gilbertorconde/libre-oven/project/docs/meireles_mf_7606_x_info.md

# Meireles MF 7606 X Oven Information

## Overview

The Meireles MF 7606 X is a built-in electric multifunction oven designed for versatile cooking. It offers a range of features to enhance your culinary experience.

## Key Features

- **Oven Type:** Electric multifunction
- **Functions:** 6 cooking functions, including:
  - Grill
  - Grill with top element
  - Bottom element
  - Top and bottom element
  - Top and bottom element with fan
  - Grill with bottom element and ventilation
- **Cooling System:** Tangential cooling fan
- **Controls:** Cylindrical knobs
- **Timer:** Minute minder
- **Interior Features:**
  - Lateral grids with anti-tilt system
  - Easy-to-clean enamel
  - Double removable glass door
- **Energy Efficiency:** Class A

## Technical Specifications

- **Oven Capacity:** 55 liters
- **Energy Consumption:**
  - Conventional heating: 0.79 kWh
  - Forced air heating: 0.75 kWh
- **Power Ratings:**
  - **Grill:** 1500 W
  - **Top element:** 1100 W
  - **Bottom element:** 1500 W
  - **Maximum power:** 2654 W
- **Electrical Requirements:** 220-240V / 50-60 Hz
- **Dimensions (W x H x D):** 598 x 580 x 500 mm
- **Packaging dimensions:** 665 x 670 x 580 mm
- **Weight:**
  - Net: 29 kg
  - Gross: 32 kg

## Function Mapping

According to official specifications, the oven has 6 functions:

1. **Grill** - 1500 W grill element
2. **Grill with top element** - Grill + Top element (1100 W)
3. **Bottom element** - Bottom element only (1500 W)
4. **Top and bottom element** - Both elements together (1100 W + 1500 W = 2600 W)
5. **Top and bottom element with fan** - Both elements + fan (convection mode)
6. **Grill with bottom element and ventilation** - Grill + Bottom + Fan

## Notes on Wiring Analysis

**Important discrepancy:** The official specifications indicate this oven **does have a grill function** (1500 W), but the wiring analysis shows that pin p4 (which would control the grill) has no wire connected.

This suggests:
- The grill might be wired differently than expected
- The grill might share wiring with another element
- The specific unit might have a modification or wiring issue
- The grill control might be integrated differently in the camshaft switch

**Recommendation:** Physically verify the presence of a grill element inside the oven cavity and trace its wiring to confirm how it's actually connected.

## Additional Resources

- Official product page: [Meireles MF 7606 X](https://www.meireles.pt/en/produto/appliances/ovens/electric-ovens/mf-7606-x/)
- Product manual: [Meireles MF 7606 X Manual](https://www.manua.ls/meireles/mf-7606-x/specifications)
- Product datasheet: [MF 7606 X Product Sheet](https://www.meireles.pt/wp-content/uploads/2020/04/MF-7606-X-%E2%80%94-Fichas-de-produto.pdf)

---

*Information gathered from web search. Specifications and features are subject to change. For the most accurate and up-to-date information, consult the official Meireles website or the product manual.*
