gilbertorconde/libre-oven/project/cad/oven-rotery-holder.FCStd

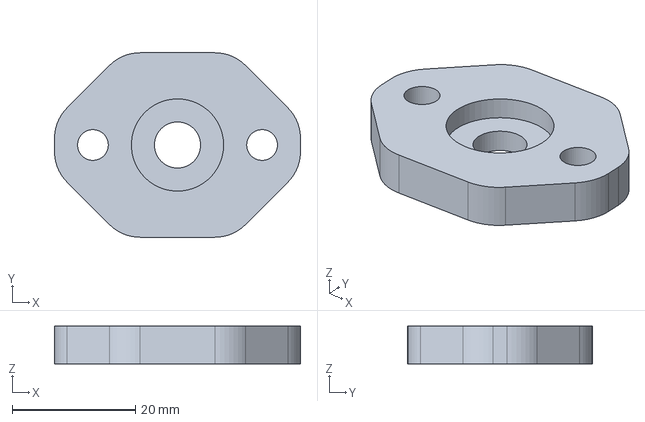
[picture p30: CAD file, 2026-03-03]
project/cad/oven-rotery-holder.FCStd
40.0 x 30.0 x 6.10 mm
