gilbertorconde/libre-oven/project/cad/lcd-box.FCStd

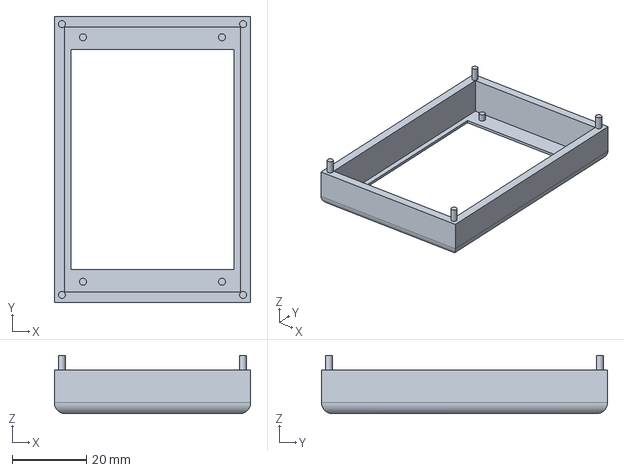
[picture p31: CAD file, 2026-03-03]
project/cad/lcd-box.FCStd
52.9 x 77.0 x 15.7 mm
