gilbertorconde/libre-oven/(list of files, cad)

Other CAD files:
project/cad/lcd-box-Body.stl
project/cad/oven-rotery-holder-Body.stl
