gilbertorconde/libre-oven/(list of files, drawings)

Other design files:
project/pcb/libre_oven_devkit.eprj
