gilbertorconde/libre-oven/project/esp32/libre_oven_s3.yaml

esphome:
  name: libre-oven
  friendly_name: Libre Oven
  comment: Libre Oven Controller Firmware
  on_boot:
    priority: -100
    then:
      - script.execute: wake_screen
      # Startup splash: sensor data needs ~10s to settle, so the UI and the
      # knobs stay disabled until then. A flag (not millis()) so the splash
      # doesn't come back when millis() wraps after ~49.7 days.
      - delay: 12s
      - globals.set:
          id: startup_done
          value: "true"

esp32:
  board: esp32-s3-devkitc-1
  variant: esp32s3
  framework:
    type: esp-idf
    sdkconfig_options:
      CONFIG_ESPTOOLPY_FLASHMODE_QIO: "y"

psram:
  mode: octal
  speed: 80MHz

# WiFi Configuration
wifi:
  ssid: !secret wifi_ssid
  password: !secret wifi_password

  # Enable fallback hotspot in case WiFi connection fails
  ap:
    ssid: "Libre-Oven-PT100 Fallback"
    password: !secret wifi_password

# Note: captive_portal is unsupported on ESP-IDF.
# improv_serial was tried but it blocks the main loop for 300-600ms,
# corrupting SPI reads from the MAX31865 RTD sensor.

# Logger - silenced except PID autotune output
logger:
  level: DEBUG
  deassert_rts_dtr: true
  logs:
    component: NONE
    sensor: ERROR
    sensor.filter: ERROR
    display: ERROR
    wifi: ERROR
    api: ERROR
    api.connection: ERROR
    ota: ERROR
    mdns: ERROR
    esp-idf: ERROR
    esp32.preferences: ERROR
    switch: ERROR
    number: ERROR
    text_sensor: ERROR
    binary_sensor: ERROR
    climate: ERROR
    pid: DEBUG
    pid.autotune: DEBUG
    pid.climate: DEBUG
    output: ERROR
    light: ERROR
    script: ERROR
    scheduler: ERROR
    max31865: NONE
    spi: ERROR
    app: ERROR

# Enable Home Assistant API
api:
  encryption:
    key: !secret api_encryption_key

# Enable Over-The-Air updates. `encryption:` with no key reuses the API
# encryption key above, so OTA images are encrypted, not just authenticated.
ota:
  - platform: esphome
    encryption:
  - platform: web_server

# Enable web server for local access
web_server:
  port: 80
  # Required: the web_server OTA above is otherwise an unauthenticated
  # firmware upload (the esphome OTA encryption doesn't cover it).
  auth:
    type: digest
    username: admin
    password: !secret ota_password

# Commit restored globals (program state, timers) to flash every 5s instead of
# the default 60s, so a power cut shortly after cancelling can't resume the
# cancelled program. NVS is wear-levelled; 5s is fine for this write volume.
preferences:
  flash_write_interval: 5s

# Status LED (onboard LED)
status_led:
  pin:
    number: GPIO48
    inverted: true

#####################################
# Display Configuration
#####################################
#
# ST7789V TFT Display - SPI (240x320 panel, landscape UI via rotation)
#   SCK:  GPIO14 (HSPI SCK)
#   MOSI: GPIO13 (HSPI MOSI)
#   CS:   GPIO15
#   DC:   GPIO12
#   BLK:  GPIO11 (Backlight PWM)
#   RST:  Not connected (using software reset)
#
#####################################

# SPI Bus for Display
spi:
  - id: spi_display
    clk_pin: GPIO14
    mosi_pin: GPIO13

  # SPI bus for MAX31865 PT100 RTD
  # Software SPI: more tolerant of long wires and noise.
  - id: spi_max31865
    clk_pin: GPIO18
    mosi_pin: GPIO16
    miso_pin: GPIO19
    # interface: software

# Display Backlight PWM
output:
  - platform: ledc
    id: backlight_pwm
    pin: GPIO11
    frequency: 1000Hz

  # Buzzer output (simple on/off beep)
  - platform: gpio
    id: buzzer_output
    pin: GPIO6

  # PID heat output: time-proportioning for SSR control.
  - platform: slow_pwm
    id: pid_heat_output
    period: 10s
    turn_on_action:
      - lambda: |-
          if (id(active_top_element)) id(top_element_relay).turn_on();
          if (id(active_bottom_element)) id(bottom_element_relay).turn_on();
          if (id(active_grill_element)) id(grill_element_relay).turn_on();
    turn_off_action:
      - lambda: |-
          id(top_element_relay).turn_off();
          id(bottom_element_relay).turn_off();
          id(grill_element_relay).turn_off();

# Backlight Control
light:
  - platform: monochromatic
    output: backlight_pwm
    name: "Display Backlight"
    id: display_backlight
    restore_mode: ALWAYS_ON
    default_transition_length: 0s

# PID Climate Controller
# Autotune results (PWM period: 2s, sensor rate: 500ms):
#   control_parameters:
#     kp: 0.06067
#     ki: 0.00026
#     kd: 3.59330
#
#   Alternative Rules:
#     Rule 'Ziegler-Nichols PI':
#       kp: 0.04550, ki: 0.00012, kd: 0.00000
#     Rule 'Pessen Integral PID':
#       kp: 0.07078, ki: 0.00037, kd: 5.03062
#     Rule 'Some Overshoot PID':
#       kp: 0.03367, ki: 0.00014, kd: 5.31808
#     Rule 'No Overshoot PID':
#       kp: 0.02022, ki: 0.00009, kd: 2.99441
#
# Previous autotune results (PWM period: 10s, sensor rate: 1s):
#   control_parameters:
#     kp: 0.06512
#     ki: 0.00032
#     kd: 3.36308
#
#   Alternative Rules:
#     Rule 'Ziegler-Nichols PI':
#       kp: 0.04884, ki: 0.00014, kd: 0.00000
#     Rule 'Pessen Integral PID':
#       kp: 0.07598, ki: 0.00046, kd: 4.70831
#     Rule 'Some Overshoot PID':
#       kp: 0.03614, ki: 0.00018, kd: 4.97736
#     Rule 'No Overshoot PID':
#       kp: 0.02171, ki: 0.00011, kd: 2.80257
climate:
  - platform: pid
    id: pid_climate
    name: "Oven PID"
    sensor: runtime_temperature
    default_target_temperature: 200°C
    heat_output: pid_heat_output
    control_parameters:
      kp: 0.06067
      ki: 0.00026
      kd: 5.59330
      min_integral: -0.3
      max_integral: 0.3
      output_averaging_samples: 10
      derivative_averaging_samples: 10
    deadband_parameters:
      threshold_high: 5.0°C
      threshold_low: -5.0°C
      kp_multiplier: 0.05
      ki_multiplier: 0.05
      deadband_output_averaging_samples: 15

# ST7789V TFT Display
color:
  - id: background_color
    hex: FFFFFF
  - id: text_color
    hex: 161616
  - id: off_element
    hex: e2e2e2
  - id: on_element
    hex: 00c0e5
  - id: hot_element
    hex: 001ee0
  - id: selected_element
    hex: 161616

display:
  # ST7789V via mipi_spi. Panel is 240x320 native; UI is 320x240 landscape.
  # rotation: 90 is upside-down on this mounting — use 270 instead.
  - platform: mipi_spi
    id: oven_display
    model: ST7789V
    spi_id: spi_display
    cs_pin: GPIO15
    dc_pin: GPIO12
    rotation: 270
    # Default is 10MHz: a full 320x240x16bit frame then takes ~123ms to send,
    # which nearly saturates the main loop at a 125ms update interval.
    # Drop to 20MHz if the panel shows artifacts.
    data_rate: 40MHz
    update_interval: 125ms
    auto_clear_enabled: true

    lambda: |-
      // Clear entire screen to black first (full physical frame, NOT offset, so
      // shifting the UI never leaves stale/garbage pixels at the edges).
      it.filled_rectangle(0, 0, it.get_width(), it.get_height(), id(background_color));

      // ── Global UI offset wrappers ─────────────────────────────────
      // Every draw call below goes through these so the whole UI can be
      // nudged by (ui_offset_x, ui_offset_y) to fine-tune centering / fix any
      // edge clipping. Tune via the HA "UI Offset X/Y" sliders, then bake the
      // values into the ui_offset_x/ui_offset_y globals.
      const int OX = id(ui_offset_x);
      const int OY = id(ui_offset_y);
      auto P  = [&](int x, int y, auto&&... a) { it.print(x + OX, y + OY, a...); };
      auto PF = [&](int x, int y, auto&&... a) { it.printf(x + OX, y + OY, a...); };
      auto LN = [&](int x1, int y1, int x2, int y2, auto&&... a) { it.line(x1 + OX, y1 + OY, x2 + OX, y2 + OY, a...); };
      auto FR = [&](int x, int y, int w, int h, auto&&... a) { it.filled_rectangle(x + OX, y + OY, w, h, a...); };
      auto RC = [&](int x, int y, int w, int h, auto&&... a) { it.rectangle(x + OX, y + OY, w, h, a...); };
      auto FC = [&](int x, int y, auto&&... a) { it.filled_circle(x + OX, y + OY, a...); };
      auto PX = [&](int x, int y, auto&&... a) { it.draw_pixel_at(x + OX, y + OY, a...); };

      // When sleeping, keep a blank frame and skip all heavy drawing.
      // This keeps runtime logic independent and avoids UI burn patterns.
      if (id(screen_sleeping)) {
        return;
      }

      // ── Startup splash (first 12 seconds) ──────────────────────
      // Sensor data is ignored for 10s; display stays 2s longer so
      // the first real median is ready before the UI appears.
      if (!id(startup_done)) {
        int cx = it.get_width() / 2;
        int cy = it.get_height() / 2;
        P(cx, cy - 20, id(font_normal), id(text_color),
                 TextAlign::CENTER, "Starting up...");

        // Animated dots: cycle 1-3 dots every ~500ms
        int dots = ((millis() / 500) % 3) + 1;
        const char *dot_str = dots == 1 ? "." : (dots == 2 ? ".." : "...");
        P(cx, cy + 15, id(font_normal), id(off_element),
                 TextAlign::CENTER, dot_str);
        return;
      }

      // ── Temperature fault: overrides every page until cleared ──────
      if (id(sensor_fault)) {
        int cx = it.get_width() / 2;
        int cy = it.get_height() / 2;
        P(cx, cy - 45, id(font_large), id(hot_element), TextAlign::CENTER,
                 id(fault_reason) == 2 ? "OVER TEMP" : "SENSOR FAULT");
        P(cx, cy - 5, id(font_normal), id(text_color), TextAlign::CENTER, "Heating disabled");
        if (std::isnan(id(current_oven_temp))) {
          P(cx, cy + 25, id(font_normal), id(text_color), TextAlign::CENTER, "Oven: --");
        } else {
          PF(cx, cy + 25, id(font_normal), id(text_color), TextAlign::CENTER,
                    "Oven: %.0f°C", id(current_oven_temp));
        }
        P(cx, it.get_height() - 8, id(font_small), id(off_element), TextAlign::BOTTOM_CENTER,
                 "Press any knob to retry");
        return;
      }

      // Get current page
      int page = id(current_page);

      // ═══════════════════════════════════════════════════════════
      // PAGE 0: MAIN SCREEN
      // ═══════════════════════════════════════════════════════════
      if (page == 0) {
        // ═══════════════════════════════════════════════════════════
        // STATE VARIABLES for 4-state / 3-state display coloring
        // ═══════════════════════════════════════════════════════════
        // SSR actual state (is it on right now?)
        bool top_ssr = id(top_element_relay).state;
        bool bottom_ssr = id(bottom_element_relay).state;
        bool grill_ssr = id(grill_element_relay).state;
        bool fan_ssr = id(fan_relay).state;
        bool light_ssr = id(light_relay).state || top_ssr || bottom_ssr || grill_ssr || fan_ssr;

        // Draft selection (user chose on mode screen)
        bool top_draft = id(desired_top_element);
        bool bottom_draft = id(desired_bottom_element);
        bool grill_draft = id(desired_grill_element);
        bool fan_draft = id(desired_fan_element);
        bool any_draft = top_draft || bottom_draft || grill_draft || fan_draft;

        // Active selection (applied to running program)
        bool top_active = id(active_top_element);
        bool bottom_active = id(active_bottom_element);
        bool grill_active = id(active_grill_element);
        bool fan_active = id(active_fan_element);
        bool any_active = top_active || bottom_active || grill_active || fan_active;

        float current_temp = id(current_oven_temp);
        float target = id(active_temperature);

        bool any_heating_active = top_active || bottom_active || grill_active;
        bool allow_heat =
          (target > 0.0f && any_heating_active) &&
          (id(timer_state) == 2 || id(timer_state) == 3 || id(timer_state) == 4);

        // ═══════════════════════════════════════════════════════════
        // 4-STATE COLOR LOGIC for heating elements (top, bottom, grill):
        //   Gray  = not selected, no program
        //   White = selected in draft, program not applied
        //   Yellow = program applied/armed, SSR off (temp cycling)
        //   Red   = SSR actually on (heating)
        // 3-STATE for non-cycling (fan, light/frame):
        //   Gray  = off
        //   White = draft selected, not active
        //   Yellow = SSR on (active)
        // ═══════════════════════════════════════════════════════════
        auto heating_color = [&](bool ssr, bool active, bool draft) -> Color {
          if (ssr)                     return id(on_element);       // red: SSR on
          if (allow_heat && active)    return id(hot_element);      // yellow: armed
          if (draft || active)         return id(selected_element); // white: draft/selected
          return id(off_element);                                   // gray: off
        };
        auto aux_color = [&](bool ssr, bool active, bool draft) -> Color {
          if (ssr)                     return id(hot_element);      // yellow: SSR on
          if (draft || active)         return id(selected_element); // white: draft/selected
          return id(off_element);                                   // gray: off
        };

        Color top_color = heating_color(top_ssr, top_active, top_draft);
        Color bottom_color = heating_color(bottom_ssr, bottom_active, bottom_draft);
        Color grill_color = heating_color(grill_ssr, grill_active, grill_draft);
        Color fan_color = aux_color(fan_ssr, fan_active, fan_draft);

      // Determine which timer to display on main screen
      int shown_sec = 0;
      Color timer_color = id(off_element);
      int state = id(timer_state);

      if (state == 1 || state == 2) {
        // Delay / preheating phase → yellow
        shown_sec = id(timer_delay_remaining);
        timer_color = id(hot_element);  // yellow-ish
      } else if (state == 3) {
        // Ready phase → green (holding at temperature)
        shown_sec = id(timer_cook_remaining);
        timer_color = id(on_element);
      } else if (state == 4) {
        // Cooking phase → green
        shown_sec = id(timer_cook_remaining);
        timer_color = id(on_element);
      } else {
        shown_sec = 0;
        timer_color = id(off_element);
      }

      // Is any program actively running?
      bool program_active = (state != 0);

      // ═══════════════════════════════════════════════════════════
      // SVG GROUP TRANSFORM: translate(54, 28.30137)
      // All oven elements offset by this amount
      // ═══════════════════════════════════════════════════════════
      const int tx = 54;
      const int ty = 28;

      // Offsets to fine-tune oven position
      const int oven_x_offset = 10;  // Horizontal offset (move right)
      const int oven_y_offset = -15; // Vertical offset (move up to center)

      // ═══════════════════════════════════════════════════════════
      // OVEN RECTANGLE (with rounded corners)
      // SVG: x=74.95, y=42.93, w=170.09, h=154.13, rx/ry=30.82
      // ═══════════════════════════════════════════════════════════
        Color oven_color = aux_color(light_ssr, any_active, any_draft);
      int oven_x = 75 + tx + oven_x_offset;     // 129 + offset
      int oven_y = 43 + ty + oven_y_offset;     // 71 + offset
      int oven_w = 170;
      int oven_h = 154;
      int corner_r = 31;

      // Draw oven_color rounded rectangle (4px stroke)
      // Straight edges
      LN(oven_x + corner_r, oven_y, oven_x + oven_w - corner_r, oven_y, oven_color);
      LN(oven_x + corner_r, oven_y + 1, oven_x + oven_w - corner_r, oven_y + 1, oven_color);
      LN(oven_x + corner_r, oven_y + 2, oven_x + oven_w - corner_r, oven_y + 2, oven_color);

      LN(oven_x + corner_r, oven_y + oven_h, oven_x + oven_w - corner_r, oven_y + oven_h, oven_color);
      LN(oven_x + corner_r, oven_y + oven_h - 1, oven_x + oven_w - corner_r, oven_y + oven_h - 1, oven_color);
      LN(oven_x + corner_r, oven_y + oven_h - 2, oven_x + oven_w - corner_r, oven_y + oven_h - 2, oven_color);

      LN(oven_x, oven_y + corner_r, oven_x, oven_y + oven_h - corner_r, oven_color);
      LN(oven_x + 1, oven_y + corner_r, oven_x + 1, oven_y + oven_h - corner_r, oven_color);
      LN(oven_x + 2, oven_y + corner_r, oven_x + 2, oven_y + oven_h - corner_r, oven_color);

      LN(oven_x + oven_w, oven_y + corner_r, oven_x + oven_w, oven_y + oven_h - corner_r, oven_color);
      LN(oven_x + oven_w - 1, oven_y + corner_r, oven_x + oven_w - 1, oven_y + oven_h - corner_r, oven_color);
      LN(oven_x + oven_w - 2, oven_y + corner_r, oven_x + oven_w - 2, oven_y + oven_h - corner_r, oven_color);

      // Rounded corners - draw only the arc quadrants using angles
      for (int r = corner_r - 2; r <= corner_r; r++) {
        // Top-left corner: 180° to 270°
        for (int angle = 180; angle <= 270; angle += 2) {
          int x = oven_x + corner_r + (int)(r * cos(angle * 3.14159 / 180));
          int y = oven_y + corner_r + (int)(r * sin(angle * 3.14159 / 180));
          PX(x, y, oven_color);
        }
        // Top-right corner: 270° to 360°
        for (int angle = 270; angle <= 360; angle += 2) {
          int x = oven_x + oven_w - corner_r + (int)(r * cos(angle * 3.14159 / 180));
          int y = oven_y + corner_r + (int)(r * sin(angle * 3.14159 / 180));
          PX(x, y, oven_color);
        }
        // Bottom-left corner: 90° to 180°
        for (int angle = 90; angle <= 180; angle += 2) {
          int x = oven_x + corner_r + (int)(r * cos(angle * 3.14159 / 180));
          int y = oven_y + oven_h - corner_r + (int)(r * sin(angle * 3.14159 / 180));
          PX(x, y, oven_color);
        }
        // Bottom-right corner: 0° to 90°
        for (int angle = 0; angle <= 90; angle += 2) {
          int x = oven_x + oven_w - corner_r + (int)(r * cos(angle * 3.14159 / 180));
          int y = oven_y + oven_h - corner_r + (int)(r * sin(angle * 3.14159 / 180));
          PX(x, y, oven_color);
        }
      }

      // ═══════════════════════════════════════════════════════════
      // TOP HEATING ELEMENT (6px thick with rounded caps)
      // Color: yellow when ON, red when heating, gray when OFF
      // ═══════════════════════════════════════════════════════════
      for (int i = 0; i < 5; i++) {
        LN(151 + oven_x_offset, 86 + i + oven_y_offset, 277 + oven_x_offset, 86 + i + oven_y_offset, top_color);
      }
      // Rounded caps at both ends
      FC(151 + oven_x_offset, 88 + oven_y_offset, 2, top_color);  // Left cap
      FC(277 + oven_x_offset, 88 + oven_y_offset, 2, top_color);  // Right cap

      // ═══════════════════════════════════════════════════════════
      // GRILL ZIGZAG PATTERN (gray, 6px stroke)
      // SVG: 8 zigzag paths starting at y=68.76+28.3=97
      // ═══════════════════════════════════════════════════════════
      int zigzag_y = 97 + oven_y_offset;
      int zigzag_start_x = 150 + oven_x_offset;

      for (int i = 0; i < 8; i++) {
        int x_base = zigzag_start_x + (i * 16);
        // Each zigzag: up 8px right, down 14px, down 8px right
        for (int t = 0; t < 3; t++) {  // 3px thick lines
          LN(x_base + t, zigzag_y, x_base + 8 + t, zigzag_y + 14, grill_color);
          LN(x_base + 8 + t, zigzag_y + 14, x_base + 16 + t, zigzag_y, grill_color);
        }
      }

      // ═══════════════════════════════════════════════════════════
      // FAN - filled gray circle with black blades and center
      // Centered horizontally in oven, below grill
      // ═══════════════════════════════════════════════════════════
      int fan_x = oven_x + oven_w / 2;      // 214 (centered)
      int fan_y = 155 + oven_y_offset;  // Centered vertically in oven

      // Fill fan circle with appropriate color (yellow when ON, gray when OFF)
      FC(fan_x, fan_y, 37, fan_color);

      // Animate fan blades only when fan SSR is ON
      static int fan_angle = 0;
      if (fan_ssr) {
        fan_angle = (fan_angle + 8) % 360;  // Rotate 8 degrees per frame
      }


      // Calculate rotated blade endpoints
      float angle_rad = fan_angle * 3.14159 / 180.0;
      float cos_a = cos(angle_rad);
      float sin_a = sin(angle_rad);

      // Original blade 1 endpoints: (-34, -20) to (34, 20)
      int x1_start = fan_x + (int)(-34 * cos_a - (-20) * sin_a);
      int y1_start = fan_y + (int)(-34 * sin_a + (-20) * cos_a);
      int x1_end = fan_x + (int)(34 * cos_a - 20 * sin_a);
      int y1_end = fan_y + (int)(34 * sin_a + 20 * cos_a);

      // Original blade 2 endpoints: (-20, 34) to (20, -34) (perpendicular)
      int x2_start = fan_x + (int)(-20 * cos_a - 34 * sin_a);
      int y2_start = fan_y + (int)(-20 * sin_a + 34 * cos_a);
      int x2_end = fan_x + (int)(20 * cos_a - (-34) * sin_a);
      int y2_end = fan_y + (int)(20 * sin_a + (-34) * cos_a);

      // Draw background-colored X-pattern blades with consistent 8px thickness
      // Use circles along the line to create consistent thick lines

      // Blade 1: draw circles along the line from start to end
      for (float t = 0; t <= 1.0; t += 0.05) {
        int x = x1_start + (int)((x1_end - x1_start) * t);
        int y = y1_start + (int)((y1_end - y1_start) * t);
        FC(x, y, 4, id(background_color));  // radius 4 = 8px diameter
      }

      // Blade 2: draw circles along the line from start to end
      for (float t = 0; t <= 1.0; t += 0.05) {
        int x = x2_start + (int)((x2_end - x2_start) * t);
        int y = y2_start + (int)((y2_end - y2_start) * t);
        FC(x, y, 4, id(background_color));  // radius 4 = 8px diameter
      }

      // Background-colored center circle (motor hub)
      FC(fan_x, fan_y, 14, id(background_color));
      FC(fan_x, fan_y, 8, fan_color);

      // ═══════════════════════════════════════════════════════════
      // BOTTOM HEATING ELEMENT (6px thick with rounded caps)
      // Color: yellow when ON, red when heating, gray when OFF
      // ═══════════════════════════════════════════════════════════
      for (int i = 0; i < 5; i++) {
        LN(151 + oven_x_offset, 204 + i + oven_y_offset, 277 + oven_x_offset, 204 + i + oven_y_offset, bottom_color);
      }
      // Rounded caps at both ends
      FC(151 + oven_x_offset, 206 + oven_y_offset, 2, bottom_color);  // Left cap
      FC(277 + oven_x_offset, 206 + oven_y_offset, 2, bottom_color);  // Right cap

      // ═══════════════════════════════════════════════════════════
      // TEXT ELEMENTS (exact SVG coordinates)
      // ═══════════════════════════════════════════════════════════

      // Timer countdown and total - centered vertically
      // Font sizes: large=27px, small=15px, spacing between=7px
      // Total height: 27 + 7 + 15 = 49px
      int time_y_offset = 45;  // Adjust this to fine-tune vertical position
      int timer_countdown_height = 27;
      int timer_spacing = 7;
      int timer_total_height = 15;
      int timer_block_height = timer_countdown_height + timer_spacing + timer_total_height;
      int timer_start_y = (it.get_height() - timer_block_height) / 2 + time_y_offset;

      // ═══════════════════════════════════════════════════════════
      // Light Bulb Icon - top right, left of WiFi
      // ═══════════════════════════════════════════════════════════
      int bulb_x = it.get_width() - 60;  // Left of WiFi symbol
      int bulb_y = 15;                   // Aligned with WiFi
      Color bulb_color = aux_color(light_ssr, any_active, any_draft);

      // Bulb glass (circle)
      for (int r = 6; r <= 8; r++) {
        FC(bulb_x, bulb_y, r, bulb_color);
      }

      // Bulb base/socket (small rectangle)
      for (int i = 0; i < 3; i++) {
        LN(bulb_x - 3, bulb_y + 9 + i, bulb_x + 3, bulb_y + 9 + i, bulb_color);
      }

      // Bulb contact point (bottom line)
      LN(bulb_x - 2, bulb_y + 13, bulb_x + 2, bulb_y + 13, bulb_color);

      // ═══════════════════════════════════════════════════════════
      // Play/Pause Status Icon - left of light bulb
      // Pause (two bars) = idle, Play (triangle) = running
      // ═══════════════════════════════════════════════════════════
      int icon_x = bulb_x - 35;
      int icon_y = bulb_y + 2;  // Shift down to center with bulb's full extent
      Color icon_color = program_active ? id(hot_element) : id(selected_element);

      if (program_active) {
        // Play triangle (pointing right, ~18x22px to match bulb height)
        for (int dx = 0; dx <= 18; dx++) {
          int half_h = 11 - (11 * dx / 18);
          LN(icon_x + dx, icon_y - half_h, icon_x + dx, icon_y + half_h, icon_color);
        }
      } else {
        // Pause icon (two vertical bars, 5px wide each, 22px tall)
        FR(icon_x, icon_y - 11, 5, 22, icon_color);
        FR(icon_x + 9, icon_y - 11, 5, 22, icon_color);
      }

      // ═══════════════════════════════════════════════════════════
      // WiFi Status Indicator - top right corner
      // ═══════════════════════════════════════════════════════════
      int wifi_x = it.get_width() - 25;  // Right side, 25px from edge
      int wifi_y = 8;                    // Top corner

      if (wifi::global_wifi_component->is_connected()) {
        // Connected - Traditional WiFi symbol (curved arcs + dot pointing up)
        int wifi_center_y = wifi_y + 18;  // Bottom center point
        
        // Draw dot at bottom center
        FC(wifi_x, wifi_center_y, 2, id(text_color));
        
        // Draw 3 concentric arcs using angle-based drawing (pointing upward)
        // Small arc (innermost)
        for (int angle = 45; angle <= 135; angle += 3) {
          float rad = angle * 3.14159 / 180.0;
          for (int r = 6; r <= 8; r++) {
            int x = wifi_x + (int)(r * cos(rad));
            int y = wifi_center_y - (int)(r * sin(rad));
            PX(x, y, id(text_color));
          }
        }
        
        // Medium arc
        for (int angle = 45; angle <= 135; angle += 3) {
          float rad = angle * 3.14159 / 180.0;
          for (int r = 11; r <= 13; r++) {
            int x = wifi_x + (int)(r * cos(rad));
            int y = wifi_center_y - (int)(r * sin(rad));
            PX(x, y, id(text_color));
          }
        }
        
        // Large arc (outermost)
        for (int angle = 45; angle <= 135; angle += 3) {
          float rad = angle * 3.14159 / 180.0;
          for (int r = 16; r <= 18; r++) {
            int x = wifi_x + (int)(r * cos(rad));
            int y = wifi_center_y - (int)(r * sin(rad));
            PX(x, y, id(text_color));
          }
        }
      } else if (wifi::global_wifi_component->has_ap()) {
        // AP Mode - Circle with 4 radiating dots (broadcasting)
        FC(wifi_x, wifi_y + 8, 5, id(on_element));              // Center circle
        FC(wifi_x - 12, wifi_y + 8, 2, id(on_element));         // Left dot
        FC(wifi_x + 12, wifi_y + 8, 2, id(on_element));         // Right dot
        FC(wifi_x, wifi_y - 4, 2, id(on_element));              // Top dot
        FC(wifi_x, wifi_y + 20, 2, id(on_element));             // Bottom dot
      } else {
        // Disconnected - X symbol
        // Draw thick X with multiple lines
        for (int i = 0; i < 3; i++) {
          LN(wifi_x - 10, wifi_y + i, wifi_x + 10, wifi_y + 16 + i, id(hot_element));      // Top-left to bottom-right
          LN(wifi_x - 10, wifi_y + 16 + i, wifi_x + 10, wifi_y + i, id(hot_element));      // Bottom-left to top-right
        }
      }

      if (program_active) {
        // ═══ RUNNING: show active countdown ═══
        if (id(timer_state) == 2) {
          P(62, timer_start_y, id(font_normal), timer_color,
                   TextAlign::TOP_CENTER, "PREHEATING");
        } else if (id(timer_state) == 3) {
          P(62, timer_start_y, id(font_normal), id(on_element),
                   TextAlign::TOP_CENTER, "OVEN READY");
          P(62, timer_start_y + timer_countdown_height + timer_spacing,
                   id(font_small), id(text_color), TextAlign::TOP_CENTER,
                   "Press to start");
        } else if (id(timer_state) == 4 && id(cook_mode) == 1 && std::isnan(id(current_food_temp))) {
          // Probe mode cooking but the probe stopped reading (unplugged, or
          // below ~15°C where the 10K divider can't tell it from unplugged)
          P(62, timer_start_y, id(font_large), id(hot_element),
                   TextAlign::TOP_CENTER, "NO PROBE");
          P(62, timer_start_y + timer_countdown_height + timer_spacing,
                   id(font_small), id(text_color), TextAlign::TOP_CENTER,
                   "Check probe");
        } else if (id(timer_state) == 4 && id(cook_mode) == 1) {
          // Probe mode cooking: show food temp → target
          float ft = id(current_food_temp);
          float ft_target = id(food_target_temperature);
          PF(62, timer_start_y, id(font_large), id(on_element),
                    TextAlign::TOP_CENTER, "%.0f°C", ft);
          if (ft_target > 0.0f) {
            PF(62, timer_start_y + timer_countdown_height + timer_spacing,
                      id(font_small), id(text_color), TextAlign::TOP_CENTER,
                      "Target: %.0f°C", ft_target);
          } else {
            P(62, timer_start_y + timer_countdown_height + timer_spacing,
                     id(font_small), id(text_color), TextAlign::TOP_CENTER,
                     "PROBE MODE");
          }
        } else {
          int hours = shown_sec / 3600;
          int rem_sec = shown_sec % 3600;
          int mins = rem_sec / 60;
          int secs = rem_sec % 60;
          PF(62, timer_start_y, id(font_large), timer_color,
                    TextAlign::TOP_CENTER, "%02d:%02d:%02d", hours, mins, secs);
        }
        // Total programmed cook time (skip in ready state and probe-mode cooking)
        if (id(timer_state) == 3) {
          // Already displayed "Press to start" above
        } else if (id(timer_state) == 4 && id(cook_mode) == 1) {
          // Probe mode: sub-message already shown above
        } else if (id(cook_total_seconds) <= 0) {
          P(62, timer_start_y + timer_countdown_height + timer_spacing,
                   id(font_small), id(text_color), TextAlign::TOP_CENTER,
                   "NO TIMER");
        } else {
          int total_sec = id(cook_total_seconds);
          if (total_sec < 0) total_sec = 0;
          int t_hours = total_sec / 3600;
          int t_rem = total_sec % 3600;
          int t_mins = t_rem / 60;
          int t_secs = t_rem % 60;
          PF(62, timer_start_y + timer_countdown_height + timer_spacing,
                    id(font_small), id(text_color), TextAlign::TOP_CENTER,
                    "%02d:%02d:%02d", t_hours, t_mins, t_secs);
        }
        // Draft change indicator (when draft differs from active)
        bool temp_diff = ((int)id(working_temperature) != (int)target);
        bool time_diff = ((int)(id(working_timer) * 60.0f) != id(cook_total_seconds));
        if (temp_diff || time_diff) {
          int draft_y = timer_start_y + timer_countdown_height + timer_spacing + timer_total_height + 6;
          PF(62, draft_y, id(font_small), id(selected_element),
                    TextAlign::TOP_CENTER, "Draft: %.0f°C", id(working_temperature));
        }
      } else {
        // ═══ IDLE: show draft values in white ═══
        float draft_dur = id(working_timer);
        if (draft_dur > 0) {
          int d_total = (int)(draft_dur * 60.0f);
          int dh = d_total / 3600;
          int dr = d_total % 3600;
          int dm = dr / 60;
          int ds = dr % 60;
          PF(62, timer_start_y, id(font_large), id(selected_element),
                    TextAlign::TOP_CENTER, "%02d:%02d:%02d", dh, dm, ds);
        } else {
          P(62, timer_start_y, id(font_normal), id(selected_element),
                   TextAlign::TOP_CENTER, "NO TIMER");
        }
        // Show draft delay
        float draft_del = id(working_start_delay);
        if (draft_del > 0) {
          int del_h = (int)draft_del / 60;
          int del_m = (int)draft_del % 60;
          PF(62, timer_start_y + timer_countdown_height + timer_spacing,
                    id(font_small), id(selected_element), TextAlign::TOP_CENTER,
                    "Delay: %02d:%02d", del_h, del_m);
        } else {
          P(62, timer_start_y + timer_countdown_height + timer_spacing,
                   id(font_small), id(selected_element), TextAlign::TOP_CENTER,
                   "Start: Now");
        }
      }

      // Knob role labels at the very bottom
      int bottom_y = it.get_height() - 4;
      P(10, bottom_y, id(font_small), id(text_color),
               TextAlign::BOTTOM_LEFT, "TIME");
      P(it.get_width() / 2, bottom_y, id(font_small), id(text_color),
               TextAlign::BOTTOM_CENTER, "MODE");
      P(it.get_width() - 10, bottom_y, id(font_small), id(text_color),
               TextAlign::BOTTOM_RIGHT, "TEMP");

      // ═══════════════════════════════════════════════════════════
      // Temperature display - above timer
      // ═══════════════════════════════════════════════════════════
      int temp_spacing = 35;
      int current_temp_y = timer_start_y - temp_spacing;
      int target_temp_y = current_temp_y - 7 - 41;

        // Main temp: active when running, draft when idle
        float main_temp = program_active ? target : id(working_temperature);
        Color main_temp_color = program_active ? id(text_color) : id(selected_element);
        PF(62, target_temp_y, id(font_xlarge), main_temp_color, TextAlign::TOP_CENTER, "%.0f°C", main_temp);

        // Current real temp (small, yellow) - below main temp
        if (std::isnan(current_temp)) {
          P(62, current_temp_y, id(font_small), id(hot_element), TextAlign::TOP_CENTER, "--°C");
        } else {
          PF(62, current_temp_y, id(font_small), id(hot_element), TextAlign::TOP_CENTER, "%.0f°C", current_temp);
        }

        // Food probe temperature (only if probe is connected)
        if (!std::isnan(id(current_food_temp))) {
          PF(62, current_temp_y + 18, id(font_small), id(on_element), TextAlign::TOP_CENTER,
                    "Food: %.0f°C", id(current_food_temp));
        }
      }

      // ═══════════════════════════════════════════════════════════
      // PAGE 1: TIMER SCREEN
      // - First step: set duration (\"No timer\" → HH:MM)
      // - Second step: set start delay (\"Now\" → HH:MM)
      //   timer_edit_phase: 0 = editing duration, 1 = editing start delay
      // ═══════════════════════════════════════════════════════════
      else if (page == 1) {
        float duration_min = id(working_timer);
        float delay_min = id(working_start_delay);
        bool editing_duration = (id(timer_edit_phase) == 0);
        bool program_running = id(timer_state) >= 1;
        // Probe connected -> this page sets the food target instead of duration.
        bool probe_mode = (id(cook_mode) == 1);

        int cx = it.get_width() / 2;

        // Title
        P(cx, 8, id(font_normal), id(text_color), TextAlign::TOP_CENTER,
                 program_running ? (probe_mode ? "EDIT PROBE" : "EDIT TIMER")
                                 : (probe_mode ? "SET PROBE" : "SET TIMER"));

        // Helper lambda to print minutes as HH:MM
        auto print_time = [&](int x, int y, float minutes, bool active) {
          if (minutes <= 0.0f) return;
          int total = (int) minutes;
          if (total < 0) total = 0;
          if (total > 23 * 60 + 59) total = 23 * 60 + 59;
          int hours = total / 60;
          int mins = total % 60;
          Color col = active ? id(on_element) : id(text_color);
          PF(x, y, id(font_large), col, TextAlign::TOP_CENTER, "%02d:%02d", hours, mins);
        };

        // Primary block: food target (probe mode) or cook duration (timer mode)
        {
          Color label_color = editing_duration ? id(on_element) : id(text_color);
          if (probe_mode) {
            P(cx, 40, id(font_small), label_color,
                     TextAlign::TOP_CENTER, "FOOD TARGET");
            float ft = id(food_target_temperature);
            if (ft <= 0.0f) {
              Color col = editing_duration ? id(on_element) : id(off_element);
              P(cx, 68, id(font_large), col,
                       TextAlign::TOP_CENTER, "NOT SET");
            } else {
              Color col = editing_duration ? id(on_element) : id(text_color);
              PF(cx, 68, id(font_large), col,
                        TextAlign::TOP_CENTER, "%.0f°C", ft);
            }
          } else {
            P(cx, 40, id(font_small), label_color,
                     TextAlign::TOP_CENTER, "DURATION");
            if (duration_min <= 0.0f) {
              Color col = editing_duration ? id(on_element) : id(off_element);
              P(cx, 68, id(font_large), col,
                       TextAlign::TOP_CENTER, "NO TIMER");
            } else {
              print_time(cx, 68, duration_min, editing_duration);
            }
          }
        }

        // Start time block (delay) - LOCKED when program is running
        {
          bool delay_locked = program_running;
          bool editing_start = !editing_duration && !delay_locked;
          Color label_color = delay_locked ? id(off_element) : (editing_start ? id(on_element) : id(text_color));
          P(cx, 120, id(font_small), label_color,
                   TextAlign::TOP_CENTER, delay_locked ? "DELAY (LOCKED)" : "WHEN TO START");

          if (delay_min <= 0.0f) {
            Color col = editing_start ? id(on_element) : id(off_element);
            P(cx, 148, id(font_large), col,
                     TextAlign::TOP_CENTER, "NOW");
          } else {
            Color col = delay_locked ? id(off_element) : (editing_start ? id(on_element) : id(text_color));
            int total = (int) delay_min;
            if (total < 0) total = 0;
            int hours = total / 60;
            int mins = total % 60;
            PF(cx, 148, id(font_large), col, TextAlign::TOP_CENTER, "%02d:%02d", hours, mins);
          }
        }

        // Instructions at bottom
        const char* msg;
        if (program_running) {
          msg = probe_mode ? "Rotate to adjust target - Press to done"
                           : "Rotate to adjust duration - Press to done";
        } else if (editing_duration) {
          msg = probe_mode ? "Rotate to set food target - Press to set start"
                           : "Rotate to set duration - Press to set start";
        } else {
          msg = "Rotate to set start - Press to done";
        }
        P(cx, it.get_height() - 8, id(font_small), id(off_element),
                 TextAlign::BOTTOM_CENTER, msg);
      }

      // ═══════════════════════════════════════════════════════════
      // PAGE 2: TEMPERATURE SETTING SCREEN
      // ═══════════════════════════════════════════════════════════
      else if (page == 2) {
        float temp = id(working_temperature);
        
        // Title
        P(it.get_width() / 2, 10, id(font_normal), id(text_color), 
                 TextAlign::TOP_CENTER, "SET TEMPERATURE");
        
        // Large temperature value (moved up)
        PF(it.get_width() / 2, 55, id(font_xlarge), id(on_element), 
                  TextAlign::TOP_CENTER, "%.0f", temp);
        P(it.get_width() / 2, 100, id(font_large), id(on_element), 
                 TextAlign::TOP_CENTER, "°C");
        
        // Temperature range bar (moved up)
        int bar_x = 40;
        int bar_y = 145;
        int bar_width = it.get_width() - 80;
        int bar_height = 20;
        
        // Background bar (outline)
        RC(bar_x, bar_y, bar_width, bar_height, id(off_element));
        
        // Filled portion based on temperature (0-280°C)
        float temp_ratio = temp / 280.0;
        if (temp_ratio > 1.0) temp_ratio = 1.0;
        if (temp_ratio < 0.0) temp_ratio = 0.0;
        int fill_width = (int)(bar_width * temp_ratio);
        if (fill_width > 2) {
          FR(bar_x + 2, bar_y + 2, fill_width - 4, bar_height - 4, id(on_element));
        }
        
        // Min/Max labels
        P(bar_x, bar_y + bar_height + 8, id(font_small), id(text_color), 
                 TextAlign::TOP_LEFT, "0°C");
        P(bar_x + bar_width, bar_y + bar_height + 8, id(font_small), id(text_color), 
                 TextAlign::TOP_RIGHT, "280°C");
        
        // Instructions at bottom
        P(it.get_width() / 2, it.get_height() - 10, id(font_small), id(off_element), 
                 TextAlign::BOTTOM_CENTER, "Rotate to adjust - Press to confirm");
      }

      // ═══════════════════════════════════════════════════════════
      // PAGE 3: MODE SCREEN - Element Selection
      // ═══════════════════════════════════════════════════════════
      else if (page == 3) {
        // Get desired element selection (independent of actual SSR state)
        bool top_on = id(desired_top_element);
        bool bottom_on = id(desired_bottom_element);
        bool grill_on = id(desired_grill_element);
        bool fan_on = id(desired_fan_element);
        
        // Title
        P(it.get_width() / 2, 10, id(font_normal), id(text_color), 
                 TextAlign::TOP_CENTER, "SELECT ELEMENTS");
        
        // Element list with toggle indicators
        int start_y = 40;
        int line_height = 32;
        int x_left = 20;
        int x_right = it.get_width() - 20;
        int selected = id(mode_selected_element);
        
        // Selection indicator (arrow)
        int arrow_x = 5;
        int arrow_y = start_y + (selected * line_height) + 10;
        P(arrow_x, arrow_y, id(font_normal), id(on_element), TextAlign::CENTER, ">");
        
        // Top Element
        Color top_text_color = (selected == 0) ? id(on_element) : id(text_color);
        P(x_left, start_y, id(font_normal), top_text_color, TextAlign::TOP_LEFT, "Top Element");
        Color top_color = top_on ? id(on_element) : id(off_element);
        P(x_right, start_y, id(font_normal), top_color, TextAlign::TOP_RIGHT, top_on ? "ON" : "OFF");
        
        // Bottom Element
        Color bottom_text_color = (selected == 1) ? id(on_element) : id(text_color);
        P(x_left, start_y + line_height, id(font_normal), bottom_text_color, TextAlign::TOP_LEFT, "Bottom Element");
        Color bottom_color = bottom_on ? id(on_element) : id(off_element);
        P(x_right, start_y + line_height, id(font_normal), bottom_color, TextAlign::TOP_RIGHT, bottom_on ? "ON" : "OFF");
        
        // Grill Element
        Color grill_text_color = (selected == 2) ? id(on_element) : id(text_color);
        P(x_left, start_y + line_height * 2, id(font_normal), grill_text_color, TextAlign::TOP_LEFT, "Grill");
        Color grill_color = grill_on ? id(on_element) : id(off_element);
        P(x_right, start_y + line_height * 2, id(font_normal), grill_color, TextAlign::TOP_RIGHT, grill_on ? "ON" : "OFF");
        
        // Fan
        Color fan_text_color = (selected == 3) ? id(on_element) : id(text_color);
        P(x_left, start_y + line_height * 3, id(font_normal), fan_text_color, TextAlign::TOP_LEFT, "Fan");
        Color fan_color = fan_on ? id(on_element) : id(off_element);
        P(x_right, start_y + line_height * 3, id(font_normal), fan_color, TextAlign::TOP_RIGHT, fan_on ? "ON" : "OFF");
        
        // Back option (not toggleable)
        Color back_text_color = (selected == 4) ? id(on_element) : id(text_color);
        P(x_left, start_y + line_height * 4, id(font_normal), back_text_color, TextAlign::TOP_LEFT, "Back");
        P(x_right, start_y + line_height * 4, id(font_normal), id(text_color), TextAlign::TOP_RIGHT, "Press");
      }

      // ═══════════════════════════════════════════════════════════
      // PAGE 4: APPLY CONFIRMATION SCREEN
      // ═══════════════════════════════════════════════════════════
      else if (page == 4) {
        int cx = it.get_width() / 2;
        bool running = id(timer_state) != 0;

        P(cx, 10, id(font_normal), id(on_element),
                 TextAlign::TOP_CENTER, running ? "UPDATE PROGRAM?" : "START PROGRAM?");

        // Draft summary
        int y = 42;
        PF(cx, y, id(font_small), id(text_color), TextAlign::TOP_CENTER,
                  "Temperature: %.0f C", id(working_temperature));
        y += 20;

        if (id(cook_mode) == 1) {
          // Probe mode: cook ends on food target, not a duration
          float ft = id(food_target_temperature);
          if (ft > 0) {
            PF(cx, y, id(font_small), id(text_color), TextAlign::TOP_CENTER,
                      "Food target: %.0f C", ft);
          } else {
            P(cx, y, id(font_small), id(text_color), TextAlign::TOP_CENTER, "Food target: NOT SET");
          }
        } else {
          float dur = id(working_timer);
          if (dur > 0) {
            int h = (int)dur / 60;
            int m = (int)dur % 60;
            PF(cx, y, id(font_small), id(text_color), TextAlign::TOP_CENTER,
                      "Duration: %02d:%02d", h, m);
          } else {
            P(cx, y, id(font_small), id(text_color), TextAlign::TOP_CENTER, "Duration: NO TIMER");
          }
        }
        y += 20;

        if (!running) {
          float del = id(working_start_delay);
          if (del > 0) {
            int dh = (int)del / 60;
            int dm = (int)del % 60;
            PF(cx, y, id(font_small), id(text_color), TextAlign::TOP_CENTER,
                      "Delay: %02d:%02d", dh, dm);
          } else {
            P(cx, y, id(font_small), id(text_color), TextAlign::TOP_CENTER, "Delay: NOW");
          }
          y += 20;
        } else {
          if (id(cook_mode) == 1) {
            // Probe mode: no countdown to update, just show the food target
            float ft = id(food_target_temperature);
            if (ft > 0) {
              PF(cx, y, id(font_small), id(text_color), TextAlign::TOP_CENTER,
                        "Food target: %.0f C", ft);
            } else {
              P(cx, y, id(font_small), id(text_color), TextAlign::TOP_CENTER, "Food target: NOT SET");
            }
          } else {
            // Show time delta for running program
            int new_total = (int)(id(working_timer) * 60.0f);
            int delta_sec = new_total - id(cook_total_seconds);
            if (delta_sec != 0) {
              int abs_d = delta_sec < 0 ? -delta_sec : delta_sec;
              int dm = abs_d / 60;
              int ds = abs_d % 60;
              char sign = delta_sec > 0 ? '+' : '-';
              PF(cx, y, id(font_small), id(hot_element), TextAlign::TOP_CENTER,
                        "Time: %c%d:%02d", sign, dm, ds);
            } else {
              P(cx, y, id(font_small), id(text_color), TextAlign::TOP_CENTER, "Time: no change");
            }
          }
          y += 20;

          // Show delay delta for running program
          int new_delay_total = (int)(id(working_start_delay) * 60.0f);
          int dd_sec = new_delay_total - id(delay_total_seconds);
          if (id(timer_state) == 1 && dd_sec != 0) {
            int abs_dd = dd_sec < 0 ? -dd_sec : dd_sec;
            int ddm = abs_dd / 60;
            int dds = abs_dd % 60;
            char dsign = dd_sec > 0 ? '+' : '-';
            PF(cx, y, id(font_small), id(hot_element), TextAlign::TOP_CENTER,
                      "Delay: %c%d:%02d", dsign, ddm, dds);
          } else if (id(timer_state) == 1) {
            P(cx, y, id(font_small), id(text_color), TextAlign::TOP_CENTER, "Delay: no change");
          } else {
            P(cx, y, id(font_small), id(text_color), TextAlign::TOP_CENTER, "Delay: passed");
          }
          y += 20;
        }

        // Element summary
        char elems[32] = "";
        if (id(desired_top_element)) strcat(elems, "Top ");
        if (id(desired_bottom_element)) strcat(elems, "Bot ");
        if (id(desired_grill_element)) strcat(elems, "Grl ");
        if (id(desired_fan_element)) strcat(elems, "Fan ");
        if (strlen(elems) == 0) strcpy(elems, "None");
        PF(cx, y, id(font_small), id(text_color), TextAlign::TOP_CENTER, "Elements: %s", elems);

        // Instructions at bottom
        P(cx, it.get_height() - 28, id(font_normal), id(on_element),
                 TextAlign::BOTTOM_CENTER, "Press TIME to confirm");
        P(cx, it.get_height() - 8, id(font_small), id(off_element),
                 TextAlign::BOTTOM_CENTER, "Any other to cancel");
      }

      // ═══════════════════════════════════════════════════════════
      // PAGE 5: CANCEL CONFIRMATION SCREEN
      // ═══════════════════════════════════════════════════════════
      else if (page == 5) {
        int cx = it.get_width() / 2;
        int cy = it.get_height() / 2;

        P(cx, cy - 40, id(font_large), id(on_element),
                 TextAlign::CENTER, "CANCEL");
        P(cx, cy - 10, id(font_large), id(on_element),
                 TextAlign::CENTER, "PROGRAM?");

        P(cx, it.get_height() - 28, id(font_normal), id(on_element),
                 TextAlign::BOTTOM_CENTER, "Press MODE to confirm");
        P(cx, it.get_height() - 8, id(font_small), id(off_element),
                 TextAlign::BOTTOM_CENTER, "Any other to cancel");
      }

      // ═══════════════════════════════════════════════════════════
      // PAGE 6: KIDS LOCK POPUP
      // ═══════════════════════════════════════════════════════════
      else if (page == 6) {
        int cx = it.get_width() / 2;
        int cy = it.get_height() / 2;
        if (id(kids_lock)) {
          P(cx, cy - 35, id(font_large), id(on_element), TextAlign::CENTER, "LOCKED");
          P(cx, cy + 5, id(font_normal), id(text_color), TextAlign::CENTER, "Child lock is on");
          P(cx, cy + 35, id(font_small), id(off_element), TextAlign::CENTER,
                   "Hold MODE + TEMP 5s to unlock");
        } else {
          P(cx, cy - 20, id(font_large), id(on_element), TextAlign::CENTER, "UNLOCKED");
          P(cx, cy + 20, id(font_small), id(off_element), TextAlign::CENTER, "Child lock off");
        }
      }

font:
  - file: "gfonts://Share Tech Mono"
    id: font_small
    size: 15 # SVG: 14.66px
    glyphs: "!?\"%()+,-_.:°*^0123456789ABCDEFGHIJKLMNOPQRSTUVWXYZ abcdefghijklmnopqrstuvwxyz/\\[]"

  - file: "gfonts://Share Tech Mono"
    id: font_normal
    size: 19 # SVG: 18.66px
    glyphs: "!?\"%()+,-_.:°*^<>0123456789ABCDEFGHIJKLMNOPQRSTUVWXYZ abcdefghijklmnopqrstuvwxyz/\\[]"

  - file: "gfonts://Share Tech Mono"
    id: font_large
    size: 27 # SVG: 26.66px (timer countdown)
    # Note: don't duplicate 'C' (it's already in A-Z)
    glyphs: "?:°0123456789ABCDEFGHIJKLMNOPQRSTUVWXYZ "

  - file: "gfonts://Share Tech Mono"
    id: font_xlarge
    size: 41 # SVG: 40.72px (target temperature)
    glyphs: ".°C0123456789"

# Global variables for page management and sleep
globals:
  - id: current_page
    type: int
    restore_value: no
    initial_value: "0" # 0=main, 1=timer, 2=temperature, 3=mode, 4=apply confirm, 5=cancel confirm, 6=kids lock

  # Kids/child lock: when true, physical knobs are disabled (HA still works)
  - id: kids_lock
    type: bool
    restore_value: yes
    initial_value: "false"

  # Timestamp (millis) when both MODE+TEMP buttons were first held together
  - id: both_buttons_pressed_since
    type: unsigned long
    restore_value: no
    initial_value: "0"

  # Prevents repeat toggling during a single both-button hold
  - id: kids_lock_gesture_handled
    type: bool
    restore_value: no
    initial_value: "false"

  - id: last_activity_time
    type: unsigned long
    restore_value: no
    initial_value: "0"

  - id: screen_sleeping
    type: bool
    restore_value: no
    initial_value: "false"

  # Global UI draw offset (px), live-tunable from Home Assistant. Shifts every
  # drawn element for minor alignment tweaks. restore_value keeps tuned values
  # across reboots; once happy, bake the final numbers into initial_value here.
  - id: ui_offset_x
    type: int
    restore_value: yes
    initial_value: "0"

  - id: ui_offset_y
    type: int
    restore_value: yes
    initial_value: "0"

  # Set 12s after boot, once the startup splash is over.
  - id: startup_done
    type: bool
    restore_value: no
    initial_value: "false"

  # Current oven cavity temperature (updated from MAX31865 PT100 RTD).
  # NAN = no valid reading (not yet read, or stale): never assume a cold oven.
  - id: current_oven_temp
    type: float
    restore_value: no
    initial_value: "NAN"

  # millis() of the last valid RTD reading (0 = none yet). Watched by the 1s
  # runtime loop: a stale reading latches a sensor fault.
  - id: last_valid_temp_ms
    type: unsigned long
    restore_value: no
    initial_value: "0"

  # Hard over-temperature limit (°C). Above this the program is cancelled
  # and heating is latched off. Max setpoint is 280°C; keep headroom for overshoot.
  - id: overtemp_limit
    type: float
    restore_value: no
    initial_value: "310.0"

  # Latched temperature fault: heating disabled until cleared by a knob press
  # while the sensor is healthy again. Reason: 1 = no valid RTD reading, 2 = over temp.
  - id: sensor_fault
    type: bool
    restore_value: no
    initial_value: "false"

  - id: fault_reason
    type: int
    restore_value: no
    initial_value: "0"

  # timer_state as of the last runtime tick, persisted so a program interrupted
  # by a power cut can be resumed (through a fresh preheat) after reboot.
  - id: saved_timer_state
    type: int
    restore_value: yes
    initial_value: "0"

  # One-shot: the power-loss resume decision runs once, on the first valid
  # temperature reading after boot.
  - id: boot_resume_checked
    type: bool
    restore_value: no
    initial_value: "false"

  # Set when resuming a cook that was already in the cooking phase: after the
  # re-preheat, continue straight to cooking instead of waiting in READY.
  - id: resumed_cook
    type: bool
    restore_value: no
    initial_value: "false"

  # Seconds spent in preheat/ready/cook for the current program. The program
  # is force-cancelled at max_program_seconds whatever the timer/probe says.
  - id: program_elapsed_seconds
    type: int
    restore_value: yes
    initial_value: "0"

  - id: max_program_seconds
    type: int
    restore_value: no
    initial_value: "28800" # 8 hours

  # Consecutive seconds the food probe has read at/above target. The cook only
  # ends after a few seconds, so a single noisy ADC sample can't stop it.
  - id: food_at_target_seconds
    type: int
    restore_value: no
    initial_value: "0"

  # Probe-mode cook lost its probe reading (shown on screen; cleared on recovery)
  - id: probe_lost
    type: bool
    restore_value: no
    initial_value: "false"

  # Working values - only updated when on correct page
  - id: working_temperature
    type: float
    restore_value: yes
    initial_value: "200.0"

  - id: working_timer
    type: float
    restore_value: yes
    initial_value: "0.0"

  # Timer start delay (minutes). 0 = Now
  - id: working_start_delay
    type: float
    restore_value: yes
    initial_value: "0.0"

  # Timer runtime state machine
  # 0 = idle, 1 = waiting (delay before cook), 2 = preheating, 3 = ready, 4 = cooking
  - id: timer_state
    type: int
    restore_value: no
    initial_value: "0"

  # Last observed timer_state used to detect program phase transitions.
  - id: last_timer_state_observed
    type: int
    restore_value: no
    initial_value: "0"

  # Remaining seconds for delay and cooking phases (for main screen)
  - id: timer_delay_remaining
    type: int
    restore_value: yes
    initial_value: "0"

  - id: timer_cook_remaining
    type: int
    restore_value: yes
    initial_value: "0"

  # Runtime counter for current preheat phase duration.
  - id: preheat_elapsed_seconds
    type: int
    restore_value: no
    initial_value: "0"

  # Preheat ramp: PID setpoint ramps from current temp toward target. Keeps PID
  # error small, preventing integral windup and overshoot. The ramp runs at up
  # to preheat_ramp_max_rate far from target and eases in exponentially near it.
  - id: preheat_ramp_setpoint
    type: float
    restore_value: no
    initial_value: "0.0"

  # Max ramp speed (°C/min), tunable from HA. The lead gate in the runtime loop
  # (40/20/10°C) means the ramp never outruns the oven, so a high value just lets
  # the oven heat at full power through the bulk of the climb.
  - id: preheat_ramp_max_rate
    type: float
    restore_value: yes
    initial_value: "15.0"

  - id: pid_heat_was_active
    type: bool
    restore_value: no
    initial_value: "false"

  # Food probe temperature (updated from NTC via ADC)
  - id: current_food_temp
    type: float
    restore_value: no
    initial_value: "NAN"

  # Food probe target temperature (0 = disabled)
  - id: food_target_temperature
    type: float
    restore_value: yes
    initial_value: "0.0"

  # Cook mode: 0 = timer (default), 1 = food probe
  - id: cook_mode
    type: int
    restore_value: yes
    initial_value: "0"

  # NTC B-constant for the food probe (configurable via web server / HA)
  # 3950 is typical for a 100K NTC meat probe; adjust to match your probe's datasheet.
  - id: food_probe_b_constant
    type: float
    restore_value: yes
    initial_value: "3950.0"

  # NTC nominal resistance at 25°C (Ω). Single-point calibration knob: set this to
  # the "Food Probe Resistance (Debug)" reading taken at a known 25°C.
  - id: food_probe_r0
    type: float
    restore_value: yes
    initial_value: "100000.0"

  # Cooling fan (light relay) stays on until temp drops below this threshold
  - id: cooldown_temp_threshold
    type: float
    restore_value: yes
    initial_value: "50.0"

  # Total programmed cook time in seconds (for display only)
  - id: cook_total_seconds
    type: int
    restore_value: yes
    initial_value: "0"

  - id: delay_total_seconds
    type: int
    restore_value: yes
    initial_value: "0"

  # Timer page edit phase: 0 = duration, 1 = start delay
  - id: timer_edit_phase
    type: int
    restore_value: no
    initial_value: "0"

  - id: working_mode
    type: float
    restore_value: yes
    initial_value: "0.0"

  # Mode screen: selected element index (0=Top, 1=Bottom, 2=Grill, 3=Fan, 4=Back)
  - id: mode_selected_element
    type: int
    restore_value: no
    initial_value: "0"

  # Active temperature target (set only via apply_program, used by runtime loop)
  - id: active_temperature
    type: float
    restore_value: yes
    initial_value: "0.0"

  # Desired element selection from mode screen (separate from actual SSR state)
  - id: desired_top_element
    type: bool
    restore_value: yes
    initial_value: "false"

  - id: desired_bottom_element
    type: bool
    restore_value: yes
    initial_value: "false"

  - id: desired_grill_element
    type: bool
    restore_value: yes
    initial_value: "false"

  - id: desired_fan_element
    type: bool
    restore_value: yes
    initial_value: "false"

  # Active element selection (set only via apply_program, used by runtime loop)
  - id: active_top_element
    type: bool
    restore_value: yes
    initial_value: "false"

  - id: active_bottom_element
    type: bool
    restore_value: yes
    initial_value: "false"

  - id: active_grill_element
    type: bool
    restore_value: yes
    initial_value: "false"

  - id: active_fan_element
    type: bool
    restore_value: yes
    initial_value: "false"

# Sensors
sensor:
  # Uptime sensor
  - platform: uptime
    id: uptime_sec
    name: "Uptime"
    update_interval: 1s

  # MAX31865 PT100 RTD (oven temperature)
  # PT100 RTD via MAX31865 - reads every 500ms for faster response.
  # The MAX31865 has built-in noise rejection and 50Hz mains filtering,
  # so only light smoothing is needed compared to the old K-type thermocouple.
  - platform: max31865
    id: oven_temperature
    name: "RTD Temperature"
    unit_of_measurement: "°C"
    accuracy_decimals: 1
    cs_pin: GPIO17
    spi_id: spi_max31865
    update_interval: 500ms
    reference_resistance: 430 Ω
    rtd_nominal_resistance: 100 Ω
    rtd_wires: 3
    mains_filter: 50Hz
    filters:
      - lambda: |-
          if (std::isnan(x) || x < 1.0f || x > 350.0f) return {};
          return x;
      - median:
          window_size: 5
          send_every: 1
          send_first_at: 1
    on_value:
      then:
        - lambda: |-
            id(current_oven_temp) = x;
            id(last_valid_temp_ms) = millis();

  # NTC 100K food probe via voltage divider on GPIO7.
  # 3.3V → 10K resistor → GPIO7 → NTC probe (2.5mm jack) → GND.
  # The fixed divider resistor is 10K (hardware); the probe nominal is 100K @ 25°C.
  # When probe is unplugged, readings are out of range → NaN.
  - platform: adc
    id: food_probe_adc
    pin: GPIO7
    attenuation: 12db
    update_interval: 2s
    internal: true

  - platform: resistance
    id: food_probe_resistance
    sensor: food_probe_adc
    configuration: DOWNSTREAM
    resistor: 10kOhm
    internal: true
    on_value:
      then:
        - lambda: |-
            // Steinhart-Hart simplified (B-parameter): T = 1 / (1/T0 + (1/B)*ln(R/R0))
            float R = x;
            float B = id(food_probe_b_constant);
            float R0 = id(food_probe_r0);  // NTC nominal resistance at 25°C (tunable)
            float T0 = 298.15f;  // 25°C in Kelvin

            // Debug: always publish the raw resistance and the computed temperature,
            // ungated, so the probe can be inspected in HA even when "disconnected".
            // These do NOT feed cooking logic or the UI.
            id(food_probe_resistance_debug).publish_state(R);
            float t_debug = NAN;
            if (!std::isnan(R) && R > 0.0f) {
              float t_kelvin = 1.0f / ((1.0f / T0) + (1.0f / B) * logf(R / R0));
              t_debug = t_kelvin - 273.15f;
            }
            id(food_probe_temperature_debug).publish_state(t_debug);

            // Functional path: gate out-of-range readings to NaN so cooking logic
            // and the UI ignore a disconnected/implausible probe.
            // With the 10K fixed divider, an UNPLUGGED 100K probe floats the node
            // high and computes to ~300K+ Ω (~1-2°C). A connected probe at usable
            // temps reads well under 160K Ω (~100-130K at room temp, far less when
            // hot), so we treat anything above 160K Ω as "disconnected".
            if (std::isnan(R) || R < 1.0f || R > 160000.0f) {
              id(current_food_temp) = NAN;
              id(food_probe_temperature).publish_state(NAN);
              return;
            }
            float t_celsius = t_debug;
            if (t_celsius < -10.0f || t_celsius > 300.0f) {
              id(current_food_temp) = NAN;
              id(food_probe_temperature).publish_state(NAN);
              return;
            }
            id(current_food_temp) = t_celsius;
            id(food_probe_temperature).publish_state(t_celsius);

  - platform: template
    id: food_probe_temperature
    name: "Food Probe Temperature"
    unit_of_measurement: "°C"
    accuracy_decimals: 1
    update_interval: never
    filters:
      - median:
          window_size: 5
          send_every: 1
          send_first_at: 1

  # Debug: ungated probe temperature (always published, even when "disconnected").
  # For probe diagnostics/tuning only — not used by cooking logic or the UI.
  - platform: template
    id: food_probe_temperature_debug
    name: "Food Probe Temperature (Debug)"
    unit_of_measurement: "°C"
    accuracy_decimals: 1
    update_interval: never
    entity_category: diagnostic

  # Debug: raw probe resistance (always published).
  - platform: template
    id: food_probe_resistance_debug
    name: "Food Probe Resistance (Debug)"
    unit_of_measurement: "Ω"
    accuracy_decimals: 0
    update_interval: never
    entity_category: diagnostic

  # Runtime temperature exposed to HA as the current oven temperature.
  # Fed by MAX31865 PT100 via current_oven_temp global.
  - platform: template
    id: runtime_temperature
    name: "Oven Temperature"
    unit_of_measurement: "°C"
    accuracy_decimals: 1
    update_interval: 1s
    lambda: |-
      return id(current_oven_temp);

  # Expose timer state as numeric code for automations/frontend:
  # 0=idle, 1=waiting, 2=preheating, 3=ready, 4=cooking
  - platform: template
    id: timer_state_code
    name: "Timer State Code"
    accuracy_decimals: 0
    update_interval: 1s
    lambda: |-
      return id(timer_state);

  - platform: template
    id: timer_delay_remaining_seconds
    name: "Delay Remaining Seconds"
    unit_of_measurement: "s"
    accuracy_decimals: 0
    update_interval: 1s
    lambda: |-
      return id(timer_delay_remaining);

  - platform: template
    id: timer_cook_remaining_seconds
    name: "Cook Remaining Seconds"
    unit_of_measurement: "s"
    accuracy_decimals: 0
    update_interval: 1s
    lambda: |-
      return id(timer_cook_remaining);

  - platform: template
    id: timer_active_countdown_seconds
    name: "Active Countdown Seconds"
    unit_of_measurement: "s"
    accuracy_decimals: 0
    update_interval: 1s
    lambda: |-
      int state = id(timer_state);
      if (state == 1 || state == 2) return id(timer_delay_remaining);
      if (state == 3 || state == 4) return id(timer_cook_remaining);
      return 0;

  # ── Element visual-state sensors for HA frontend SVG ──
  # 0 = gray (off), 1 = white (draft/selected), 2 = yellow (armed/active-aux), 3 = red (SSR on/heating)
  - platform: template
    id: ha_top_element_state
    name: "Top Element State"
    icon: "mdi:radiator"
    accuracy_decimals: 0
    update_interval: 1s
    lambda: |-
      bool ssr = id(top_element_relay).state;
      bool active = id(active_top_element);
      bool draft = id(desired_top_element);
      bool any_heating = id(active_top_element) || id(active_bottom_element) || id(active_grill_element);
      float target = id(active_temperature);
      bool allow_heat = (target > 0.0f && any_heating) &&
        (id(timer_state) == 2 || id(timer_state) == 3 || id(timer_state) == 4);
      if (ssr)                    return 3;  // red
      if (allow_heat && active)   return 2;  // yellow
      if (draft || active)        return 1;  // white
      return 0;                              // gray

  - platform: template
    id: ha_bottom_element_state
    name: "Bottom Element State"
    icon: "mdi:radiator"
    accuracy_decimals: 0
    update_interval: 1s
    lambda: |-
      bool ssr = id(bottom_element_relay).state;
      bool active = id(active_bottom_element);
      bool draft = id(desired_bottom_element);
      bool any_heating = id(active_top_element) || id(active_bottom_element) || id(active_grill_element);
      float target = id(active_temperature);
      bool allow_heat = (target > 0.0f && any_heating) &&
        (id(timer_state) == 2 || id(timer_state) == 3 || id(timer_state) == 4);
      if (ssr)                    return 3;  // red
      if (allow_heat && active)   return 2;  // yellow
      if (draft || active)        return 1;  // white
      return 0;                              // gray

  - platform: template
    id: ha_grill_element_state
    name: "Grill Element State"
    icon: "mdi:grill"
    accuracy_decimals: 0
    update_interval: 1s
    lambda: |-
      bool ssr = id(grill_element_relay).state;
      bool active = id(active_grill_element);
      bool draft = id(desired_grill_element);
      bool any_heating = id(active_top_element) || id(active_bottom_element) || id(active_grill_element);
      float target = id(active_temperature);
      bool allow_heat = (target > 0.0f && any_heating) &&
        (id(timer_state) == 2 || id(timer_state) == 3 || id(timer_state) == 4);
      if (ssr)                    return 3;  // red
      if (allow_heat && active)   return 2;  // yellow
      if (draft || active)        return 1;  // white
      return 0;                              // gray

  - platform: template
    id: ha_fan_element_state
    name: "Fan Element State"
    icon: "mdi:fan"
    accuracy_decimals: 0
    update_interval: 1s
    lambda: |-
      bool ssr = id(fan_relay).state;
      bool active = id(active_fan_element);
      bool draft = id(desired_fan_element);
      if (ssr)                    return 2;  // yellow (aux max)
      if (draft || active)        return 1;  // white
      return 0;                              // gray

  - platform: template
    id: ha_frame_state
    name: "Oven Frame State"
    icon: "mdi:rectangle-outline"
    accuracy_decimals: 0
    update_interval: 1s
    lambda: |-
      bool any_ssr = id(top_element_relay).state || id(bottom_element_relay).state ||
                     id(grill_element_relay).state || id(fan_relay).state;
      bool light_ssr = id(light_relay).state || any_ssr;
      bool any_draft = id(desired_top_element) || id(desired_bottom_element) ||
                       id(desired_grill_element) || id(desired_fan_element);
      bool any_active = id(active_top_element) || id(active_bottom_element) ||
                        id(active_grill_element) || id(active_fan_element);
      if (light_ssr)              return 2;  // yellow
      if (any_draft || any_active) return 1; // white
      return 0;                              // gray

  # Temperature Encoder (GPIO41, GPIO42)
  - platform: rotary_encoder
    id: encoder_temperature
    name: "Temperature Encoder"
    internal: true
    pin_a:
      number: GPIO42
      mode: INPUT_PULLUP
    pin_b:
      number: GPIO41
      mode: INPUT_PULLUP
    resolution: 2
    # Use a large range so clamping never stops delta detection;
    # we still clamp working_temperature itself to 0–280°C.
    min_value: -32768
    max_value: 32767
    publish_initial_value: true
    on_value:
      then:
        - lambda: |-
            // Track the counter before the startup guard: publish_initial_value
            // seeds last_val at boot, so the first real detent isn't swallowed.
            static float last_val = x;
            float delta = x - last_val;
            last_val = x;

            // Ignore encoder input during startup splash
            if (!id(startup_done)) return;

            bool was_sleeping = id(screen_sleeping);
            id(wake_screen).execute();
            if (delta == 0) return;

            // Temperature fault: rotation only wakes the screen (press clears)
            if (id(sensor_fault)) return;

            // Kids lock: ignore rotation, just show the lock popup
            if (id(kids_lock)) { id(current_page) = 6; return; }

            // If screen was sleeping, just wake it - don't navigate or adjust
            if (was_sleeping) return;

            int direction = (delta > 0) ? 1 : -1;

            // From main screen: rotate navigates to temperature page
            if (id(current_page) == 0) {
              id(current_page) = 2;
              return;
            }

            if (id(current_page) == 2) {
              // On temperature page: fine adjust 1 by 1 (°C)
              id(working_temperature) += direction * 1;
              if (id(working_temperature) < 0) id(working_temperature) = 0;
              if (id(working_temperature) > 280) id(working_temperature) = 280;
            } else if (id(current_page) == 1) {
              // On timer page (coarse steps).
              if (id(timer_edit_phase) == 0) {
                if (id(cook_mode) == 1) {
                  // Probe mode: set food target temperature (10°C steps)
                  id(food_target_temperature) += direction * 10;
                  if (id(food_target_temperature) < 0) id(food_target_temperature) = 0;
                  if (id(food_target_temperature) > 300) id(food_target_temperature) = 300;
                } else {
                  // Timer mode: adjust duration in 30 min steps
                  id(working_timer) += direction * 30.0f;
                  if (id(working_timer) < 0) id(working_timer) = 0;
                }
              } else {
                id(working_start_delay) += direction * 30.0f;
                if (id(working_start_delay) < 0) id(working_start_delay) = 0;
              }
            }

  # Timer Encoder (GPIO9, GPIO10)
  - platform: rotary_encoder
    id: encoder_timer
    name: "Timer Encoder"
    internal: true
    pin_a:
      number: GPIO10
      mode: INPUT_PULLUP
    pin_b:
      number: GPIO9
      mode: INPUT_PULLUP
    resolution: 4
    # Use a large range so clamping never stops delta detection
    min_value: -32768
    max_value: 32767
    publish_initial_value: true
    on_value:
      then:
        - lambda: |-
            // Track the counter before the startup guard: publish_initial_value
            // seeds last_val at boot, so the first real detent isn't swallowed.
            static float last_val = x;
            float delta = x - last_val;
            last_val = x;

            // Ignore encoder input during startup splash
            if (!id(startup_done)) return;

            bool was_sleeping = id(screen_sleeping);
            id(wake_screen).execute();
            if (delta == 0) return;

            // Temperature fault: rotation only wakes the screen (press clears)
            if (id(sensor_fault)) return;

            // Kids lock: ignore rotation, just show the lock popup
            if (id(kids_lock)) { id(current_page) = 6; return; }

            // If screen was sleeping, just wake it - don't navigate or adjust
            if (was_sleeping) return;

            int direction = (delta > 0) ? 1 : -1;

            // From main screen: rotate navigates to timer page
            if (id(current_page) == 0) {
              id(current_page) = 1;
              id(timer_edit_phase) = 0;
              return;
            }

            if (id(current_page) == 2) {
              // On temperature page: change temperature 10 by 10
              id(working_temperature) += direction * 10;
              if (id(working_temperature) < 0) id(working_temperature) = 0;
              if (id(working_temperature) > 280) id(working_temperature) = 280;
            } else if (id(current_page) == 1) {
              // On timer page (fine steps).
              if (id(timer_edit_phase) == 0) {
                if (id(cook_mode) == 1) {
                  // Probe mode: set food target temperature (1°C steps)
                  id(food_target_temperature) += direction * 1;
                  if (id(food_target_temperature) < 0) id(food_target_temperature) = 0;
                  if (id(food_target_temperature) > 300) id(food_target_temperature) = 300;
                } else {
                  // Timer mode: adjust duration in 1 min steps
                  id(working_timer) += direction * 1.0f;
                  if (id(working_timer) < 0) id(working_timer) = 0;
                }
              } else {
                // Lock delay editing when program is running
                if (id(timer_state) == 0) {
                  id(working_start_delay) += direction * 1.0f;
                  if (id(working_start_delay) < 0) id(working_start_delay) = 0;
                }
              }
            }

  # Mode Encoder (GPIO38, GPIO39)
  # Use a large range so the value never clamps: clamping at 0/10 caused
  # "one direction not registering" (delta stayed 0 at the boundary).
  - platform: rotary_encoder
    id: encoder_mode
    name: "Mode Encoder"
    internal: true
    pin_a:
      number: GPIO39
      mode: INPUT_PULLUP
    pin_b:
      number: GPIO38
      mode: INPUT_PULLUP
    resolution: 2
    min_value: -32768
    max_value: 32767
    publish_initial_value: true
    on_value:
      then:
        - lambda: |-
            // Track the counter before the startup guard: publish_initial_value
            // seeds last_val at boot, so the first real detent isn't swallowed.
            static float last_val = x;
            float delta = x - last_val;
            last_val = x;

            // Ignore encoder input during startup splash
            if (!id(startup_done)) return;

            bool was_sleeping = id(screen_sleeping);
            id(wake_screen).execute();
            if (delta == 0) return;

            // Temperature fault: rotation only wakes the screen (press clears)
            if (id(sensor_fault)) return;

            // Kids lock: ignore rotation, just show the lock popup
            if (id(kids_lock)) { id(current_page) = 6; return; }

            // If screen was sleeping, just wake it - don't navigate or adjust
            if (was_sleeping) return;

            int direction = (delta > 0) ? 1 : -1;

            // From main screen: rotate navigates to mode page
            if (id(current_page) == 0) {
              id(current_page) = 3;
              return;
            }

            if (id(current_page) == 2) {
              // On temperature page: adjust 5 by 5
              id(working_temperature) += direction * 5;
              if (id(working_temperature) < 0) id(working_temperature) = 0;
              if (id(working_temperature) > 280) id(working_temperature) = 280;
            } else if (id(current_page) == 1) {
              // On timer page (medium steps).
              if (id(timer_edit_phase) == 0) {
                if (id(cook_mode) == 1) {
                  // Probe mode: set food target temperature (5°C steps)
                  id(food_target_temperature) += direction * 5;
                  if (id(food_target_temperature) < 0) id(food_target_temperature) = 0;
                  if (id(food_target_temperature) > 300) id(food_target_temperature) = 300;
                } else {
                  // Timer mode: adjust duration in 10 min steps
                  id(working_timer) += direction * 10.0f;
                  if (id(working_timer) < 0) id(working_timer) = 0;
                }
              } else {
                if (id(timer_state) == 0) {
                  id(working_start_delay) += direction * 10.0f;
                  if (id(working_start_delay) < 0) id(working_start_delay) = 0;
                }
              }
            } else if (id(current_page) == 3) {
              // On mode page: navigate through elements
              id(mode_selected_element) += direction;
              if (id(mode_selected_element) < 0) id(mode_selected_element) = 4;
              if (id(mode_selected_element) > 4) id(mode_selected_element) = 0;
            }

  # Active target temperature (set via apply_program, read-only for HA)
  - platform: template
    id: active_temperature_sensor
    name: "Active Temperature"
    unit_of_measurement: "°C"
    accuracy_decimals: 0
    update_interval: 1s
    lambda: |-
      return id(active_temperature);

  - platform: template
    id: active_cook_total_sensor
    name: "Active Cook Total"
    unit_of_measurement: "min"
    accuracy_decimals: 0
    update_interval: 1s
    lambda: |-
      return id(cook_total_seconds) / 60.0f;

  - platform: template
    id: active_delay_total_sensor
    name: "Active Delay Total"
    unit_of_measurement: "min"
    accuracy_decimals: 0
    update_interval: 1s
    lambda: |-
      return id(delay_total_seconds) / 60.0f;

  # ── PID tuning readout sensors ──
  - platform: pid
    name: "PID Heat Output"
    type: HEAT
    climate_id: pid_climate

  - platform: pid
    name: "PID Proportional"
    type: PROPORTIONAL
    climate_id: pid_climate

  - platform: pid
    name: "PID Integral"
    type: INTEGRAL
    climate_id: pid_climate

  - platform: pid
    name: "PID Derivative"
    type: DERIVATIVE
    climate_id: pid_climate

  - platform: pid
    name: "PID Error"
    type: ERROR
    climate_id: pid_climate

  - platform: pid
    name: "PID Kp"
    type: KP
    climate_id: pid_climate

  - platform: pid
    name: "PID Ki"
    type: KI
    climate_id: pid_climate

  - platform: pid
    name: "PID Kd"
    type: KD
    climate_id: pid_climate

# Home Assistant high-level controls (mirror physical UI behavior)
number:
  - platform: template
    id: ha_set_temperature
    name: "Set Temperature"
    icon: "mdi:thermometer"
    unit_of_measurement: "°C"
    min_value: 0
    max_value: 280
    step: 1
    mode: box
    update_interval: 1s
    lambda: |-
      return id(working_temperature);
    set_action:
      - lambda: |-
          if (x < 0) x = 0;
          if (x > 280) x = 280;
          id(working_temperature) = x;

  - platform: template
    id: ha_set_cook_duration
    name: "Cook Duration"
    icon: "mdi:timer-outline"
    unit_of_measurement: "min"
    min_value: 0
    max_value: 1439
    step: 1
    mode: box
    update_interval: 1s
    lambda: |-
      return id(working_timer);
    set_action:
      - lambda: |-
          if (x < 0) x = 0;
          if (x > 1439) x = 1439;
          id(working_timer) = x;

  - platform: template
    id: ha_set_start_delay
    name: "Start Delay"
    icon: "mdi:clock-start"
    unit_of_measurement: "min"
    min_value: 0
    max_value: 1439
    step: 1
    mode: box
    update_interval: 1s
    lambda: |-
      return id(working_start_delay);
    set_action:
      - lambda: |-
          if (x < 0) x = 0;
          if (x > 1439) x = 1439;
          id(working_start_delay) = x;

  - platform: template
    id: ha_food_target_temperature
    name: "Food Target Temperature"
    icon: "mdi:thermometer-check"
    unit_of_measurement: "°C"
    min_value: 0
    max_value: 300
    step: 1
    mode: box
    update_interval: 1s
    lambda: |-
      return id(food_target_temperature);
    set_action:
      - lambda: |-
          if (x < 0) x = 0;
          if (x > 300) x = 300;
          id(food_target_temperature) = x;

  - platform: template
    id: ha_cook_mode
    name: "Cook Mode"
    icon: "mdi:swap-horizontal"
    min_value: 0
    max_value: 1
    step: 1
    mode: box
    update_interval: 1s
    # Read-only: cook mode is auto-selected from probe presence
    # (0 = TIMER when unplugged, 1 = PROBE when connected). Manual changes are
    # ignored and the control snaps back to the current auto value.
    lambda: |-
      return id(cook_mode);
    set_action:
      - lambda: |-
          id(ha_cook_mode).publish_state(id(cook_mode));

  - platform: template
    id: ha_food_probe_b_constant
    name: "Food Probe B-Constant"
    icon: "mdi:thermometer-lines"
    min_value: 2000
    max_value: 5000
    step: 1
    mode: box
    update_interval: 1s
    lambda: |-
      return id(food_probe_b_constant);
    set_action:
      - lambda: |-
          if (x < 2000) x = 2000;
          if (x > 5000) x = 5000;
          id(food_probe_b_constant) = x;

  - platform: template
    id: ha_food_probe_r0
    name: "Food Probe R0 (25C)"
    icon: "mdi:omega"
    unit_of_measurement: "Ω"
    min_value: 1000
    max_value: 200000
    step: 100
    mode: box
    update_interval: 1s
    lambda: |-
      return id(food_probe_r0);
    set_action:
      - lambda: |-
          if (x < 1000) x = 1000;
          if (x > 200000) x = 200000;
          id(food_probe_r0) = x;

  # Preheat speed: max ramp rate of the PID setpoint. Lower it if preheat
  # overshoots the target; raise it if the oven sits below the ramp at full power.
  - platform: template
    id: ha_preheat_ramp_max_rate
    name: "Preheat Ramp Max Rate"
    icon: "mdi:speedometer"
    unit_of_measurement: "°C/min"
    entity_category: config
    min_value: 3
    max_value: 30
    step: 1
    mode: box
    update_interval: 1s
    lambda: |-
      return id(preheat_ramp_max_rate);
    set_action:
      - lambda: |-
          if (x < 3) x = 3;
          if (x > 30) x = 30;
          id(preheat_ramp_max_rate) = x;

  # Live display alignment: drag these until the UI is fully on-screen (no
  # clipped edges), then copy the values into ui_offset_x/ui_offset_y globals.
  - platform: template
    id: ha_ui_offset_x
    name: "UI Offset X"
    icon: "mdi:arrow-left-right"
    unit_of_measurement: "px"
    min_value: -40
    max_value: 40
    step: 1
    mode: slider
    update_interval: 1s
    lambda: |-
      return id(ui_offset_x);
    set_action:
      - lambda: |-
          if (x < -40) x = -40;
          if (x > 40) x = 40;
          id(ui_offset_x) = (int) x;

  - platform: template
    id: ha_ui_offset_y
    name: "UI Offset Y"
    icon: "mdi:arrow-up-down"
    unit_of_measurement: "px"
    min_value: -40
    max_value: 40
    step: 1
    mode: slider
    update_interval: 1s
    lambda: |-
      return id(ui_offset_y);
    set_action:
      - lambda: |-
          if (x < -40) x = -40;
          if (x > 40) x = 40;
          id(ui_offset_y) = (int) x;

# Text sensors
text_sensor:
  # IP Address
  - platform: wifi_info
    ip_address:
      id: ip_address
      name: "IP Address"

  - platform: template
    id: timer_state_text
    name: "Timer State"
    update_interval: 1s
    lambda: |-
      int state = id(timer_state);
      if (state == 1) return std::string("WAITING");
      if (state == 2) return std::string("PREHEATING");
      if (state == 3) return std::string("READY");
      if (state == 4) return std::string("COOKING");
      return std::string("IDLE");

  - platform: template
    id: timer_delay_remaining_formatted
    name: "Delay Remaining"
    update_interval: 1s
    lambda: |-
      int sec = id(timer_delay_remaining);
      if (sec < 0) sec = 0;
      int h = sec / 3600;
      int m = (sec % 3600) / 60;
      int s = sec % 60;
      char buf[16];  // fits int hours up to 6 digits: "596523:59:59"
      snprintf(buf, sizeof(buf), "%02d:%02d:%02d", h, m, s);
      return std::string(buf);

  - platform: template
    id: timer_cook_remaining_formatted
    name: "Cook Remaining"
    update_interval: 1s
    lambda: |-
      int sec = id(timer_cook_remaining);
      if (sec < 0) sec = 0;
      int h = sec / 3600;
      int m = (sec % 3600) / 60;
      int s = sec % 60;
      char buf[16];  // fits int hours up to 6 digits: "596523:59:59"
      snprintf(buf, sizeof(buf), "%02d:%02d:%02d", h, m, s);
      return std::string(buf);

  - platform: template
    id: timer_active_countdown_formatted
    name: "Active Countdown"
    update_interval: 1s
    lambda: |-
      int state = id(timer_state);
      int sec = 0;
      if (state == 1 || state == 2) sec = id(timer_delay_remaining);
      else if (state == 3 || state == 4) sec = id(timer_cook_remaining);
      if (sec < 0) sec = 0;
      int h = sec / 3600;
      int m = (sec % 3600) / 60;
      int s = sec % 60;
      char buf[16];  // fits int hours up to 6 digits: "596523:59:59"
      snprintf(buf, sizeof(buf), "%02d:%02d:%02d", h, m, s);
      return std::string(buf);

# Binary sensors
binary_sensor:
  # Food probe connected detection
  - platform: template
    id: ha_food_probe_connected
    name: "Food Probe Connected"
    icon: "mdi:thermometer-probe"
    lambda: |-
      return !std::isnan(id(current_food_temp));

  # Latched temperature fault (no valid RTD reading, or over temp)
  - platform: template
    id: ha_temperature_fault
    name: "Temperature Fault"
    device_class: problem
    lambda: |-
      return id(sensor_fault);

  # Active element flags (what's in the running program) — for draft-change detection
  - platform: template
    id: ha_active_top_element
    name: "Active Top Element"
    lambda: |-
      return id(active_top_element);
  - platform: template
    id: ha_active_bottom_element
    name: "Active Bottom Element"
    lambda: |-
      return id(active_bottom_element);
  - platform: template
    id: ha_active_grill_element
    name: "Active Grill Element"
    lambda: |-
      return id(active_grill_element);
  - platform: template
    id: ha_active_fan_element
    name: "Active Fan Element"
    lambda: |-
      return id(active_fan_element);

  # API connection status
  - platform: status
    id: api_connected
    name: "API Connection"

  # Temperature Encoder Button (GPIO47)
  - platform: gpio
    id: button_temperature
    name: "Temperature Button"
    internal: true
    pin:
      number: GPIO47
      mode: INPUT_PULLUP
      inverted: true
    filters:
      - delayed_on: 30ms
      - delayed_off: 30ms
    # Acts on release (short click only): holding MODE + TEMP for the kids
    # lock gesture must not trigger either button's action.
    on_click:
      min_length: 10ms
      max_length: 1500ms
      then:
        - lambda: |-
            // Released while MODE is still held: part of the lock gesture
            if (id(button_mode).state) return;
            bool was_sleeping = id(screen_sleeping);
            id(wake_screen).execute();
            if (id(sensor_fault)) { id(clear_sensor_fault).execute(); return; }
            // Kids lock: ignore the press, just show the lock popup
            if (id(kids_lock)) { id(current_page) = 6; return; }
            if (!was_sleeping) {
              int page = id(current_page);
              if (page == 0 && id(timer_state) == 3) {
                id(timer_state) = 4;
              } else if (page == 0) {
                // Main screen: temp button does nothing (just wake)
              } else if (page == 4 || page == 5) {
                // On confirmation screens: any non-confirm button cancels back to main
                id(current_page) = 0;
              } else {
                id(current_page) = 0;
              }
            }

  # Timer Encoder Button (GPIO8)
  - platform: gpio
    id: button_timer
    name: "Timer Button"
    internal: true
    pin:
      number: GPIO8
      mode: INPUT_PULLUP
      inverted: true
    filters:
      - delayed_on: 30ms
      - delayed_off: 30ms
    on_press:
      then:
        - lambda: |-
            bool was_sleeping = id(screen_sleeping);
            id(wake_screen).execute();
            if (id(sensor_fault)) { id(clear_sensor_fault).execute(); return; }
            // Kids lock: ignore the press, just show the lock popup
            if (id(kids_lock)) { id(current_page) = 6; return; }
            if (!was_sleeping) {
              int page = id(current_page);
              if (page == 0 && id(timer_state) == 3) {
                id(timer_state) = 4;
              } else if (page == 0) {
                // Main screen: timer press → go to Apply Confirmation screen
                id(current_page) = 4;
              } else if (page == 4) {
                id(apply_program).execute();
                id(current_page) = 0;
              } else if (page == 5) {
                id(current_page) = 0;
              } else if (page == 1) {
                // On timer sub-screen: phase toggle / return to main (no applying)
                if (id(timer_edit_phase) == 0) {
                  // If program is running, skip delay editing (locked)
                  if (id(timer_state) >= 1) {
                    // Delay locked while running, just return to main
                    id(timer_edit_phase) = 0;
                    id(current_page) = 0;
                  } else {
                    id(timer_edit_phase) = 1;
                  }
                } else {
                  id(timer_edit_phase) = 0;
                  id(current_page) = 0;
                }
              } else {
                id(current_page) = 0;
              }
            }

  # Mode Encoder Button (GPIO40)
  - platform: gpio
    id: button_mode
    name: "Mode Button"
    internal: true
    pin:
      number: GPIO40
      mode: INPUT_PULLUP
      inverted: true
    filters:
      - delayed_on: 30ms
      - delayed_off: 30ms
    # Acts on release (short click only): holding MODE + TEMP for the kids
    # lock gesture must not trigger either button's action (e.g. cancel).
    on_click:
      min_length: 10ms
      max_length: 1500ms
      then:
        - lambda: |-
            // Released while TEMP is still held: part of the lock gesture
            if (id(button_temperature).state) return;
            bool was_sleeping = id(screen_sleeping);
            id(wake_screen).execute();
            if (id(sensor_fault)) { id(clear_sensor_fault).execute(); return; }
            // Kids lock: ignore the press, just show the lock popup
            if (id(kids_lock)) { id(current_page) = 6; return; }
            if (!was_sleeping) {
              int page = id(current_page);
              if (page == 0 && id(timer_state) == 3) {
                id(timer_state) = 4;
              } else if (page == 0) {
                // Main screen: mode press → go to Cancel Confirmation screen
                id(current_page) = 5;
              } else if (page == 5) {
                id(cancel_program).execute();
                id(current_page) = 0;
              } else if (page == 4) {
                id(current_page) = 0;
              } else if (page == 3) {
                // On mode sub-screen: toggle selected element or go back
                int selected = id(mode_selected_element);
                if (selected == 4) {
                  id(current_page) = 0;
                } else {
                  bool new_state;
                  if (selected == 0) {
                    new_state = !id(desired_top_element);
                    id(desired_top_element) = new_state;
                  } else if (selected == 1) {
                    new_state = !id(desired_bottom_element);
                    id(desired_bottom_element) = new_state;
                  } else if (selected == 2) {
                    new_state = !id(desired_grill_element);
                    id(desired_grill_element) = new_state;
                  } else if (selected == 3) {
                    new_state = !id(desired_fan_element);
                    id(desired_fan_element) = new_state;
                  }
                }
              } else {
                id(current_page) = 0;
              }
            }

  # System ON/OFF state
  - platform: template
    id: system_on
    name: "System ON"
    lambda: |-
      bool any_ssr_on =
        id(top_element_relay).state ||
        id(bottom_element_relay).state ||
        id(grill_element_relay).state ||
        id(fan_relay).state;
      return any_ssr_on || id(timer_state) != 0;

# Scripts
script:
  # Apply all draft values to the active runtime (start or update a program)
  - id: apply_program
    then:
      - lambda: |-
          // Never start/update a program without a trustworthy oven temperature
          if (id(sensor_fault) || std::isnan(id(current_oven_temp))) return;

          // Copy draft values to active
          id(active_temperature) = id(working_temperature);
          id(active_top_element) = id(desired_top_element);
          id(active_bottom_element) = id(desired_bottom_element);
          id(active_grill_element) = id(desired_grill_element);
          id(active_fan_element) = id(desired_fan_element);

          if (id(timer_state) == 0) {
            // IDLE: start a fresh program
            id(preheat_elapsed_seconds) = 0;
            id(program_elapsed_seconds) = 0;
            id(resumed_cook) = false;
            id(food_at_target_seconds) = 0;
            id(probe_lost) = false;
            id(timer_cook_remaining) = (int)(id(working_timer) * 60.0f);
            id(cook_total_seconds) = id(timer_cook_remaining);
            id(timer_delay_remaining) = (int)(id(working_start_delay) * 60.0f);
            id(delay_total_seconds) = id(timer_delay_remaining);
            bool needs_preheat = id(active_temperature) > 0.0f &&
              (id(active_top_element) || id(active_bottom_element) || id(active_grill_element));
            if (!needs_preheat) {
              // Fan-only or no heating: skip straight to cooking
              id(timer_state) = id(timer_delay_remaining) > 0 ? 1 : 4;
            } else {
              if (id(timer_delay_remaining) > 0) {
                id(timer_state) = 1;
              } else {
                float init_sp = id(current_oven_temp) + 20.0f;
                if (init_sp > id(active_temperature)) init_sp = id(active_temperature);
                id(preheat_ramp_setpoint) = init_sp;
                id(timer_state) = 2;
              }
            }
          } else {
            // RUNNING: update the active program
            // Duration: calculate delta from last applied total and add to remaining
            int new_total = (int)(id(working_timer) * 60.0f);
            int delta = new_total - id(cook_total_seconds);
            int new_remaining = id(timer_cook_remaining) + delta;
            id(timer_cook_remaining) = new_remaining > 0 ? new_remaining : 0;
            id(cook_total_seconds) = new_total;

            // Delay: apply delta to remaining, jump forward if new delay already elapsed
            int new_delay_total = (int)(id(working_start_delay) * 60.0f);
            int delay_delta = new_delay_total - id(delay_total_seconds);
            int new_delay_remaining = id(timer_delay_remaining) + delay_delta;
            id(delay_total_seconds) = new_delay_total;

            if (id(timer_state) == 1) {
              // Currently in WAITING: update the countdown
              if (new_delay_remaining <= 0) {
                // New delay is shorter than time already elapsed — advance immediately
                id(timer_delay_remaining) = 0;
                bool needs_preheat = id(active_temperature) > 0.0f &&
                  (id(active_top_element) || id(active_bottom_element) || id(active_grill_element));
                if (needs_preheat) {
                  float init_sp = id(current_oven_temp) + 20.0f;
                  if (init_sp > id(active_temperature)) init_sp = id(active_temperature);
                  id(preheat_ramp_setpoint) = init_sp;
                  id(timer_state) = 2;
                } else {
                  id(timer_state) = 4;
                }
              } else {
                id(timer_delay_remaining) = new_delay_remaining;
              }
            }
            // If already past WAITING (preheating/cooking), delay change is recorded
            // in delay_total_seconds but doesn't affect the current phase.
          }

  # Cancel the running program and reset everything
  - id: cancel_program
    then:
      - lambda: |-
          auto call = id(pid_climate).make_call();
          call.set_mode("OFF");
          if (!std::isnan(id(current_oven_temp))) {
            call.set_target_temperature(id(current_oven_temp));
          }
          call.perform();
          id(pid_heat_was_active) = false;
          id(top_element_relay).turn_off();
          id(bottom_element_relay).turn_off();
          id(grill_element_relay).turn_off();
          id(fan_relay).turn_off();
          // light_relay (cooling fan) stays on -- managed by cooldown logic in 1s interval
          id(timer_state) = 0;
          id(saved_timer_state) = 0;  // don't resume this program after a power cut
          id(program_elapsed_seconds) = 0;
          id(resumed_cook) = false;
          id(food_at_target_seconds) = 0;
          id(probe_lost) = false;
          id(timer_delay_remaining) = 0;
          id(timer_cook_remaining) = 0;
          id(preheat_elapsed_seconds) = 0;
          id(cook_total_seconds) = 0;
          id(delay_total_seconds) = 0;
          id(active_temperature) = 0.0f;
          id(working_temperature) = 0.0f;
          id(working_timer) = 0.0f;
          id(working_start_delay) = 0.0f;
          id(desired_top_element) = false;
          id(desired_bottom_element) = false;
          id(desired_grill_element) = false;
          id(desired_fan_element) = false;
          id(active_top_element) = false;
          id(active_bottom_element) = false;
          id(active_grill_element) = false;
          id(active_fan_element) = false;
          id(mode_selected_element) = 0;

  # Latch a temperature fault: cancel the program, kill heating, alert.
  # Called by the 1s runtime loop with the reason in fault_reason.
  - id: trigger_sensor_fault
    then:
      - lambda: |-
          id(sensor_fault) = true;
          id(cancel_program).execute();
          id(current_page) = 0;
      - script.execute: wake_screen
      - script.execute: buzzer_cook_finished

  # Clear a latched fault, but only once the RTD reads valid and safe again
  - id: clear_sensor_fault
    then:
      - lambda: |-
          bool fresh = id(last_valid_temp_ms) != 0 &&
                       millis() - id(last_valid_temp_ms) < 5000;
          float t = id(current_oven_temp);
          if (fresh && !std::isnan(t) && t < id(overtemp_limit) - 20.0f) {
            id(sensor_fault) = false;
            id(fault_reason) = 0;
          }

  # Wake screen and reset activity timer
  - id: wake_screen
    then:
      - lambda: |-
          id(last_activity_time) = millis();
      - if:
          condition:
            lambda: "return id(screen_sleeping);"
          then:
            - lambda: |-
                id(screen_sleeping) = false;
            - light.turn_on: display_backlight
            - component.update: oven_display

  # Put screen to sleep
  - id: sleep_screen
    then:
      - if:
          condition:
            lambda: "return !id(screen_sleeping);"
          then:
            - lambda: |-
                id(screen_sleeping) = true;
            - component.update: oven_display
            - light.turn_off: display_backlight

  # Return to main page after timeout
  - id: return_to_main
    then:
      - lambda: |-
          if (id(current_page) != 0) {
            id(current_page) = 0;
          }

  # Beep the buzzer when cooking finishes (3 short beeps)
  - id: buzzer_cook_finished
    then:
      - output.turn_on: buzzer_output
      - delay: 200ms
      - output.turn_off: buzzer_output
      - delay: 200ms
      - output.turn_on: buzzer_output
      - delay: 200ms
      - output.turn_off: buzzer_output
      - delay: 200ms
      - output.turn_on: buzzer_output
      - delay: 400ms
      - output.turn_off: buzzer_output

  # Beep the buzzer when preheating finishes (fast 2-beep pattern)
  - id: buzzer_preheat_finished
    then:
      - output.turn_on: buzzer_output
      - delay: 120ms
      - output.turn_off: buzzer_output
      - delay: 120ms
      - output.turn_on: buzzer_output
      - delay: 180ms
      - output.turn_off: buzzer_output

# Intervals for runtime and sleep management
interval:
  # Kids lock gesture: hold MODE + TEMP buttons together for 5s to toggle the lock.
  # Buttons are inverted, so .state == true means physically pressed. This runs
  # independently of on_press, so the unlock gesture works even while locked.
  - interval: 250ms
    then:
      - lambda: |-
          bool both = id(button_mode).state && id(button_temperature).state;
          if (both) {
            if (id(both_buttons_pressed_since) == 0) {
              id(both_buttons_pressed_since) = millis();
            } else if (!id(kids_lock_gesture_handled) &&
                       millis() - id(both_buttons_pressed_since) >= 5000) {
              id(kids_lock) = !id(kids_lock);
              id(kids_lock_gesture_handled) = true;
              id(current_page) = 6;            // show LOCKED/UNLOCKED feedback
              id(wake_screen).execute();
              id(buzzer_preheat_finished).execute();  // audible feedback
            }
          } else {
            id(both_buttons_pressed_since) = 0;
            id(kids_lock_gesture_handled) = false;
          }

  # Core oven runtime loop (1 Hz): temperature watchdog, power-loss resume,
  # timer state machine and SSR gating.
  # Temperature is read from MAX31865 PT100 via current_oven_temp global.
  - interval: 1s
    then:
      - lambda: |-
          int previous_state = id(last_timer_state_observed);
          unsigned long now_ms = millis();

          // ── Temperature watchdog ──
          // The MAX31865 filter drops faulted/implausible readings, so a dead
          // sensor shows up as "no new value", not as NAN. A reading older than
          // 5s is unknown (NAN); once past startup, unknown or over-temp latches
          // a fault that cancels the program and keeps heating off.
          bool temp_fresh = id(last_valid_temp_ms) != 0 &&
                            now_ms - id(last_valid_temp_ms) < 5000;
          if (!temp_fresh) id(current_oven_temp) = NAN;
          float current_temp = id(current_oven_temp);
          if (!id(sensor_fault)) {
            int reason = 0;
            if (!temp_fresh && id(startup_done)) reason = 1;
            else if (temp_fresh && current_temp > id(overtemp_limit)) reason = 2;
            if (reason != 0) {
              id(fault_reason) = reason;
              id(trigger_sensor_fault).execute();
            }
          }

          // ── Power-loss resume (once, on the first valid reading after boot) ──
          if (!id(boot_resume_checked) && temp_fresh) {
            id(boot_resume_checked) = true;
            int saved = id(saved_timer_state);
            float saved_target = id(active_temperature);
            bool saved_heating = id(active_top_element) || id(active_bottom_element) ||
                                 id(active_grill_element);
            if (id(timer_state) == 0 && saved != 0 && !id(sensor_fault)) {
              if (saved == 1 && id(timer_delay_remaining) > 0) {
                // Still in the start delay: keep counting it down
                id(timer_state) = 1;
              } else if (saved_target > 0.0f && saved_heating) {
                // The oven cooled during the outage: always re-preheat. A cook
                // that had already started continues straight to cooking after.
                float init_sp = current_temp + 20.0f;
                if (init_sp > saved_target) init_sp = saved_target;
                id(preheat_ramp_setpoint) = init_sp;
                id(resumed_cook) = (saved == 4);
                id(timer_state) = 2;
              } else {
                id(timer_state) = 4;
              }
            } else if (id(timer_state) == 0) {
              // Nothing to resume: drop program state left over from before the reboot
              id(active_temperature) = 0.0f;
              id(active_top_element) = false;
              id(active_bottom_element) = false;
              id(active_grill_element) = false;
              id(active_fan_element) = false;
              id(timer_cook_remaining) = 0;
              id(timer_delay_remaining) = 0;
              id(cook_total_seconds) = 0;
              id(delay_total_seconds) = 0;
              id(program_elapsed_seconds) = 0;
            }
          }

          float target = id(active_temperature);

          // Timer state machine (NO auto-start; programs only start via apply_program)
          int state = id(timer_state);

          // Cook mode follows the probe: connected -> PROBE (1), otherwise TIMER (0).
          // Only derived while idle so the mode is latched for the whole run and
          // unplugging the probe mid-cook can't switch modes underneath us.
          // Not before the resume decision: a resumed program keeps its restored mode.
          if (state == 0 && id(boot_resume_checked)) {
            id(cook_mode) = std::isnan(id(current_food_temp)) ? 0 : 1;
          }

          bool heating_elements_selected =
            id(active_top_element) ||
            id(active_bottom_element) ||
            id(active_grill_element);

          if (state == 1) {
            // Waiting (delay before cook) - elements should stay off here
            if (id(timer_delay_remaining) > 0) {
              id(timer_delay_remaining)--;
            }
            if (id(timer_delay_remaining) <= 0) {
              id(timer_delay_remaining) = 0;
              bool needs_preheat = target > 0.0f && heating_elements_selected;
              if (needs_preheat) {
                float init_sp = current_temp + 20.0f;
                if (init_sp > target) init_sp = target;
                id(preheat_ramp_setpoint) = init_sp;
                id(timer_state) = 2;
              } else {
                id(timer_state) = 4;
              }
            }
          } else if (state == 2) {
            if (!(target > 0.0f && heating_elements_selected)) {
              // Program was updated to no heat (temp 0 or no heating elements):
              // there is nothing to preheat, so don't sit in PREHEATING forever.
              id(resumed_cook) = false;
              id(timer_state) = 4;
            } else {
              // Preheating: ramp PID setpoint from current temp toward target
              if (id(preheat_elapsed_seconds) < 2147483647) {
                id(preheat_elapsed_seconds)++;
              }

              // Ramp the setpoint toward target. Speed scales with the distance
              // left (0.4/min, i.e. a 2.5 min time constant), capped at
              // preheat_ramp_max_rate: full speed for the bulk of the climb, then
              // an exponential ease-in over the last ~35°C so the oven lands on
              // target without overshoot. Floor of 3°C/min so the tail still ends.
              // Adaptive: only advance while the setpoint leads the oven by less
              // than max_lead. The lead sets how hard the PID pushes: at a 20°C
              // lead the derivative term (kd on the measured rise) holds output
              // near 50% at a 7.5°C/min climb, so far from target allow 40°C
              // (full power), then 20°C, then 10°C for the last 20°C to land.
              // Must exceed deadband threshold_high (5°C) so PID gets full gains during ramp.
              float ramp_rate = (target - id(preheat_ramp_setpoint)) * 0.4f;
              if (ramp_rate > id(preheat_ramp_max_rate)) ramp_rate = id(preheat_ramp_max_rate);
              if (ramp_rate < 3.0f) ramp_rate = 3.0f;
              float ramp_step = ramp_rate / 60.0f;
              float remaining = target - current_temp;
              float max_lead = remaining > 40.0f ? 40.0f : (remaining >= 20.0f ? 20.0f : 10.0f);
              float ramp_error = id(preheat_ramp_setpoint) - current_temp;
              if (ramp_error < max_lead) {
                id(preheat_ramp_setpoint) += ramp_step;
                if (id(preheat_ramp_setpoint) > target) {
                  id(preheat_ramp_setpoint) = target;
                }
              }

              // Safety timeout, independent of the ramp speed: as long as a
              // 6°C/min climb would take, + 25%. Prevents getting stuck if the
              // oven can't reach the target.
              int timeout_sec = (int)(target / 6.0f * 60.0f * 1.25f);
              bool timed_out = timeout_sec > 0 && id(preheat_elapsed_seconds) >= timeout_sec;
              bool reached = current_temp >= target - 1.0f;
              if (timed_out || reached) {
                id(pid_climate).reset_integral_term();
                // READY waits for a press before cooking; a cook resumed after a
                // power cut had already been started, so it skips that gate.
                bool wait_ready = !id(resumed_cook) &&
                                  (id(cook_total_seconds) > 0 || id(cook_mode) == 1);
                id(timer_state) = wait_ready ? 3 : 4;
                id(resumed_cook) = false;
                id(buzzer_preheat_finished).execute();
              }
            }
          } else if (state == 3) {
            // Ready: oven at temp, holding, waiting for user to press any button
            // PID and fan keep running (handled by allow_heat / allow_fan)
            // No countdown — held until pressed or the max program time cap
          } else if (state == 4) {
            // Cooking: behavior depends on cook_mode
            if (id(cook_mode) == 0) {
              // Timer mode: decrement countdown, auto-stop at 0
              if (id(timer_cook_remaining) > 0) {
                id(timer_cook_remaining)--;
                if (id(timer_cook_remaining) <= 0) {
                  id(timer_cook_remaining) = 0;
                  id(timer_state) = 0;
                  id(cancel_program).execute();
                  id(buzzer_cook_finished).execute();
                }
              }
            } else if (id(cook_mode) == 1) {
              // Probe mode: auto-stop when food has held the target for 5s
              float food = id(current_food_temp);
              float food_target = id(food_target_temperature);
              if (std::isnan(food)) {
                // Probe unplugged, or food below ~15°C (indistinguishable with the
                // 10K divider): show NO PROBE and keep cooking; no beep, since cold
                // food would false-alarm. The max program time cap still ends the run.
                id(food_at_target_seconds) = 0;
                if (!id(probe_lost)) {
                  id(probe_lost) = true;
                  id(wake_screen).execute();
                }
              } else {
                id(probe_lost) = false;
                if (food_target > 0.0f && food >= food_target) {
                  id(food_at_target_seconds)++;
                } else {
                  id(food_at_target_seconds) = 0;
                }
                if (id(food_at_target_seconds) >= 5) {
                  id(timer_state) = 0;
                  id(cancel_program).execute();
                  id(buzzer_cook_finished).execute();
                }
              }
            }
          }

          // Hard cap on preheat + ready + cook time, whatever the timer/probe says
          if (id(timer_state) >= 2) {
            id(program_elapsed_seconds)++;
            if (id(program_elapsed_seconds) >= id(max_program_seconds)) {
              id(cancel_program).execute();
              id(buzzer_cook_finished).execute();
            }
          }

          // Re-read: the state machine, a fault or the cap may have cancelled
          target = id(active_temperature);

          // Allow heating only in preheat/ready/cook (states 2-4), with a valid temperature
          bool any_heating_active =
            id(active_top_element) ||
            id(active_bottom_element) ||
            id(active_grill_element);

          bool allow_heat =
            !id(sensor_fault) && !std::isnan(current_temp) &&
            (target > 0.0f && any_heating_active) &&
            (id(timer_state) == 2 || id(timer_state) == 3 || id(timer_state) == 4);

          // PID target: use ramp setpoint during preheating, final target otherwise
          float pid_target = (id(timer_state) == 2) ? id(preheat_ramp_setpoint) : target;

          if (allow_heat) {
            if (!id(pid_heat_was_active) || id(pid_climate).mode != climate::CLIMATE_MODE_HEAT) {
              auto call = id(pid_climate).make_call();
              call.set_mode("HEAT");
              call.set_target_temperature(pid_target);
              call.perform();
            } else if (id(pid_climate).target_temperature != pid_target) {
              auto call = id(pid_climate).make_call();
              call.set_target_temperature(pid_target);
              call.perform();
            }
          } else {
            // Not heating: keep the PID OFF every tick. Its default (HEAT on a
            // fresh flash), its restored mode, or a change from HA must never
            // leave it driving slow_pwm while idle. Relays are forced off too.
            id(top_element_relay).turn_off();
            id(bottom_element_relay).turn_off();
            id(grill_element_relay).turn_off();
            if (id(pid_climate).mode != climate::CLIMATE_MODE_OFF) {
              auto call = id(pid_climate).make_call();
              call.set_mode("OFF");
              if (!std::isnan(current_temp)) call.set_target_temperature(current_temp);
              call.perform();
            } else if (!std::isnan(current_temp) &&
                       id(pid_climate).target_temperature != current_temp) {
              auto call = id(pid_climate).make_call();
              call.set_target_temperature(current_temp);
              call.perform();
            }
          }
          id(pid_heat_was_active) = allow_heat;

          // Fan runs when selected and program is active (no temperature requirement)
          bool program_active = (id(timer_state) == 2 || id(timer_state) == 3 || id(timer_state) == 4);
          bool allow_fan = id(active_fan_element) && program_active;
          if (allow_fan) {
            id(fan_relay).turn_on();
          } else {
            id(fan_relay).turn_off();
          }

          // Cooling fan (light relay): ON when heating, fan running, or temp above
          // safe threshold. Unknown temperature (sensor fault) counts as hot.
          if (allow_heat || allow_fan) {
            id(light_relay).turn_on();
          } else if (std::isnan(current_temp) || current_temp > id(cooldown_temp_threshold)) {
            id(light_relay).turn_on();
          } else {
            id(light_relay).turn_off();
          }

          // Persist the program phase for power-loss resume (not before the
          // resume decision, or the saved state would be overwritten with idle)
          if (id(boot_resume_checked)) {
            id(saved_timer_state) = id(timer_state);
          }

          // Wake display when runtime program phase changes
          if (id(timer_state) == 2 && previous_state != 2) {
            id(preheat_elapsed_seconds) = 0;
          }
          if (id(timer_state) != previous_state) {
            id(last_timer_state_observed) = id(timer_state);
            id(wake_screen).execute();
          }

          // Keep screen awake while in ready state (waiting for user) or faulted
          if (id(timer_state) == 3 || id(sensor_fault)) {
            id(wake_screen).execute();
          }

          // Auto-dismiss the kids lock popup ~5s after the last knob touch
          if (id(current_page) == 6 && millis() - id(last_activity_time) > 5000) {
            id(return_to_main).execute();
          }

  # Check for sleep timeout (every 5 seconds)
  - interval: 5s
    then:
      - lambda: |-
          unsigned long now = millis();
          unsigned long idle_time = now - id(last_activity_time);

          // Main page: sleep after 60 seconds
          if (id(current_page) == 0 && idle_time > 60000 && !id(screen_sleeping)) {
            id(sleep_screen).execute();
          }

          // Detail pages: return to main after 60 seconds
          if (id(current_page) != 0 && idle_time > 60000) {
            id(return_to_main).execute();
          }
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
