gilbertorconde/libre-oven/(commit log)

2026-03-03 Initial commit: Libre Oven smart oven controller
    ESP32-S3 ESPHome firmware with PID temperature control, TFT display,
    rotary encoders, and Home Assistant integration. Includes custom PCB
    design, 3D-printable enclosures, wiring guide, and a custom Lovelace
    card with live SVG oven visualization. HACS-compatible.
    [lcd-box-Body.stl, lcd-box.FCStd, libre_oven_devkit.eprj, oven-rotery-holder-Body.stl, oven-rotery-holder.FCStd]
2026-03-03 add hacs button to readme
2026-03-25 add support to meat probe, improve PID tunning
    [libre_oven_devkit.eprj]
2026-06-25 add kids lock, expose to HA, migrate display to mipi_spi
    - add child lock toggled by holding MODE+TEMP knobs 5s; gated knobs show
    a transient LOCKED popup while HA controls keep working
    - expose lock as ha_kids_lock switch and a header toggle in the lovelace card
    - migrate display from deprecated ili9xxx platform to mipi_spi
2026-07-01 add food probe support
2026-07-01 fix display: use ST7789V mipi_spi and restore UI colors
    Panel is ST7789V, not ILI9341. Switch to mipi_spi with rotation 270
    and swap R/B on accent colors that were tuned for the old driver.
    [libre_oven_s3.yaml]
2026-10-11 esp32: require authentication on the web server
    The web_server OTA platform serves a firmware upload page on port 80.
    It is not covered by the esphome OTA password; it relies on the
    web_server's own auth, which was not configured. Anyone on the LAN
    could flash firmware, or use the same page to set the temperature,
    disable the kids lock and start a program.
    Enable digest auth, reusing the existing ota_password secret.
2026-10-11 esp32: raise display SPI clock to 40MHz
    mipi_spi defaults to 10MHz. A full 320x240 16-bit frame then takes
    ~123ms to send, and the display redraws every 125ms, so the flush
    alone nearly saturates the main loop. 40MHz cuts it to ~31ms.
2026-10-11 esp32: gate startup on a flag instead of millis()
    The startup splash and the encoder input guard used millis() < 12000.
    millis() wraps after ~49.7 days, which brought the splash back and
    ignored the knobs for 12s on a running oven. Set a startup_done flag
    from on_boot after 12s instead.
    Also update each encoder's last_val before the startup guard. The
    static was first initialised on the first event after startup, so the
    first real detent after boot computed a zero delta and was dropped.
    publish_initial_value now seeds it at boot. Drop the on_boot
    publish_state() calls on the encoders: they did nothing useful and
    would now seed last_val with the working value.
2026-10-11 esp32: debounce knob buttons, act on release for MODE/TEMP
    The button binary sensors had no debounce. A bouncing TIME press on
    the main screen opens the apply confirmation and the bounce confirms
    it, starting a program; a bouncing MODE press does the same with
    cancel. Add 30ms delayed_on/delayed_off filters to all three.
    MODE and TEMP acted on press, so starting the hold-both kids lock
    gesture triggered the first button's action (e.g. confirming a
    cancel on the cancel page). Act on release of a short click instead,
    and ignore the release while the other button is still held.
2026-10-11 esp32: add temperature fault cutoff and runtime safety limits
    Several paths could leave the heating elements on with nothing in the
    firmware to stop them:
    - The MAX31865 filter drops NAN and out-of-range readings, so a failed
    RTD left current_oven_temp at its last value (initially 20.0) and
    the PID kept heating. Track the time of the last valid reading; a
    reading older than 5s is unknown (NAN), and after startup an unknown
    or >310C reading latches a fault that cancels the program, keeps
    heating off and shows a fault screen. A knob press clears it once
    the sensor is healthy. Exposed to HA as "Temperature Fault".
    - The idle branch never set the PID mode to OFF. It defaults to HEA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
2026-10-11 esp32: speed up preheat with a distance-scaled ramp
    The preheat ramp moved the PID setpoint at a fixed 6C/min, so 25 to
    200C took ~30 min before the setpoint even reached the target. History
    from a real preheat shows the PID holding ~30% output while tracking
    the ramp, after briefly climbing 8C/min at full power: the ramp, not
    the oven, was the limit.
    Scale the ramp speed with the distance left (0.4/min), capped at
    preheat_ramp_max_rate (default 15C/min, tunable from HA) and floored
    at 3C/min. The oven runs at full power for the bulk of the climb and
    eases in exponentially over the last ~35C, a gentler landing than the
    old fixed rate. The 20C lead gate still keeps the setpoint from
    outrunni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
2026-10-11 esp32: let the preheat setpoint lead by 40/20/10C
    A 200C preheat with the distance-scaled ramp took 30 min with a
    +2.1C peak, but held the PID output near 50% for most of the climb.
    The setpoint could lead the oven by at most 20C, and at that lead the
    derivative term (kd 5.59, acting on the measured rise) cancels about
    half of P + I at a 7.5C/min climb, so the oven never ran at full power.
    Make the maximum lead depend on the distance left to the target: 40C
    while more than 40C away, so P overpowers the derivative brake and
    the oven heats at full power; 20C from 40C to 20C away, as in the
    measured run; 10C over the last 20C for a gentler landing.
2026-10-11 esp32: enlarge timer text buffers to fix format-truncation warnings
    The Delay Remaining, Cook Remaining and Active Countdown text sensors
    format HH:MM:SS into a 12-byte buffer. Hours come from an int, so GCC
    sees a worst case of 13 bytes ("596523:59:59") and warns about
    truncation. Real timers never get close, but use 16 bytes so the
    build is warning-free.
2026-10-11 card: render incrementally, show offline/fault, fix cook mode
    Rendering: the card rebuilt its whole shadow DOM on every state
    change (about once a second), and ignored updates entirely while a
    sheet was open, freezing temperatures, timers and inputs. Build the
    skeleton once and patch only what changed. Sheets render into
    persistent containers, so an open sheet keeps updating; a focused
    input is left alone and values sent to HA are held until HA reflects
    them (max 3s) so controls don't snap back. The fan and draft-hint
    animations no longer restart every second. Use overflow: clip so
    focusing an input mid-slide can't scroll the card's contents.
    Cook mode: the firmware makes cook_mode read-onl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
2026-10-11 card: open temperature history from the preheat during a program
    Tapping the current oven temperature opened the more-info dialog,
    whose graph can't be given a start time, so a session's preheat was
    usually off the left edge. During a program, open HA's History panel
    instead, starting a minute before the program's preheat. The start
    is found from the recorder: walk back through timer_state_code to the
    last idle state, take the first entry into preheating in that run
    (the run's start for programs without preheat), skipping unavailable
    gaps from power loss. When idle, or if the lookup fails, keep opening
    more-info.
2026-11-10 esp32: encrypt OTA with the API key instead of an OTA password
    ESPHome warns that the OTA password wastes flash and RAM and recommends
    encryption. With an empty encryption: block the esphome OTA platform reuses
    api_encryption_key, so images are encrypted, not just authenticated.
    ota_password stays, now only as the web interface (digest auth) password.
